nherbaut/pico-power-sensor/config/README.md

# Configuration

Store shared, non-secret schemas and examples here. Put credentials and local deployment values in ignored `config/local/` or `.env` files.

Per-run configuration must include the Pi model/RAM, HAT model, cooling policy, peripherals and external power boundaries, OS/kernel, software versions, UART/marker mapping, acquisition settings and calibration revision.
