nherbaut/pico-power-sensor/nodes/README.md

# Instruments

Use `PP-xxx` for instruments and separate identifiers for DUTs. A single instrument can measure several Pi/HAT configurations.

Copy the [instrument template](_template/README.md) only after creating a real instrument. No assembled instrument exists yet.
