nherbaut/pico-power-sensor/hardware/pcb/carrier/pinout.csv

reference | pin | net
J_PICO | 1 | PICO_TX
J_PICO | 2 | PICO_RX
J_PICO | 3 | GND
J_PICO | 4 | PICO_MARK
J_PICO | 5 | ALERT
J_PICO | 6 | LED1_GPIO
J_PICO | 7 | LED2_GPIO
J_PICO | 8 | GND
J_PICO | 9 | LED3_GPIO
J_PICO | 10 | LED4_GPIO
J_PICO | 11 | LED5_GPIO
J_PICO | 12 | NC
J_PICO | 13 | GND
J_PICO | 14 | NC
J_PICO | 15 | NC
J_PICO | 16 | SD_MISO
J_PICO | 17 | SD_CS
J_PICO | 18 | GND
J_PICO | 19 | SD_SCLK
J_PICO | 20 | SD_MOSI
J_PICO | 21 | MISO
J_PICO | 22 | CS
J_PICO | 23 | GND
J_PICO | 24 | SCLK
J_PICO | 25 | MOSI
J_PICO | 26 | NC
J_PICO | 27 | NC
J_PICO | 28 | GND
J_PICO | 29 | NC
J_PICO | 30 | NC
J_PICO | 31 | NC
J_PICO | 32 | NC
J_PICO | 33 | GND
J_PICO | 34 | NC
J_PICO | 35 | NC
J_PICO | 36 | PICO_3V3
J_PICO | 37 | NC
J_PICO | 38 | GND
J_PICO | 39 | NC
J_PICO | 40 | USB_5V
J_UART | 1 | GND
J_UART | 2 | PICO_RX
J_UART | 3 | PICO_TX
J_UART | 4 | PICO_MARK
J_UART | 5 | PICO_3V3
J_EVM | 1 | CS
J_EVM | 2 | NC
J_EVM | 3 | SCLK
J_EVM | 4 | GND
J_EVM | 5 | MOSI
J_EVM | 6 | PICO_3V3
J_EVM | 7 | MISO
J_EVM | 8 | ALERT
J_EVM | 9 | NC
J_EVM | 10 | NC
J_EVM | 11 | NC
J_EVM | 12 | NC
D1 | 1 | GND
D1 | 2 | LED1_A
R_LED1 | 1 | LED1_GPIO
R_LED1 | 2 | LED1_A
R_PD1 | 1 | LED1_GPIO
R_PD1 | 2 | GND
D2 | 1 | GND
D2 | 2 | LED2_A
R_LED2 | 1 | LED2_GPIO
R_LED2 | 2 | LED2_A
R_PD2 | 1 | LED2_GPIO
R_PD2 | 2 | GND
D3 | 1 | GND
D3 | 2 | LED3_A
R_LED3 | 1 | LED3_GPIO
R_LED3 | 2 | LED3_A
R_PD3 | 1 | LED3_GPIO
R_PD3 | 2 | GND
D4 | 1 | GND
D4 | 2 | LED4_A
R_LED4 | 1 | LED4_GPIO
R_LED4 | 2 | LED4_A
R_PD4 | 1 | LED4_GPIO
R_PD4 | 2 | GND
D5 | 1 | GND
D5 | 2 | LED5_A
R_LED5 | 1 | LED5_GPIO
R_LED5 | 2 | LED5_A
R_PD5 | 1 | LED5_GPIO
R_PD5 | 2 | GND
R_CS | 1 | PICO_3V3
R_CS | 2 | CS
C1 | 1 | PICO_3V3
C1 | 2 | GND
C2 | 1 | PICO_3V3
C2 | 2 | GND
TP1 | 1 | PICO_3V3
TP2 | 1 | GND
J_SD | 1 | SD_DAT2
J_SD | 2 | SD_CS
J_SD | 3 | SD_MOSI
J_SD | 4 | SD_3V3
J_SD | 5 | SD_SCLK
J_SD | 6 | GND
J_SD | 7 | SD_MISO
J_SD | 8 | SD_DAT1
J_SD | 9 | GND
U_SD | 1 | USB_5V
U_SD | 2 | GND
U_SD | 3 | PICO_3V3
U_SD | 4 | NC
U_SD | 5 | SD_3V3
R_SDP1 | 1 | SD_3V3
R_SDP1 | 2 | SD_DAT2
R_SDP2 | 1 | SD_3V3
R_SDP2 | 2 | SD_CS
R_SDP3 | 1 | SD_3V3
R_SDP3 | 2 | SD_MOSI
R_SDP4 | 1 | SD_3V3
R_SDP4 | 2 | SD_MISO
R_SDP5 | 1 | SD_3V3
R_SDP5 | 2 | SD_DAT1
C_SDIN | 1 | USB_5V
C_SDIN | 2 | GND
C_SDOUT | 1 | SD_3V3
C_SDOUT | 2 | GND
C_SDBULK | 1 | SD_3V3
C_SDBULK | 2 | GND
C_SDSOCKET | 1 | SD_3V3
C_SDSOCKET | 2 | GND
