nherbaut/pico-power-sensor/hardware/pcb/carrier/schematic.png

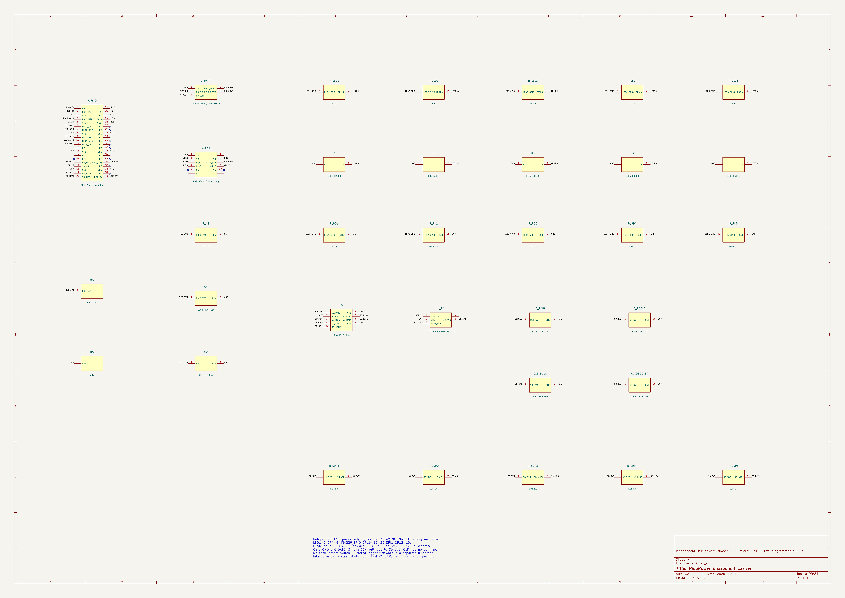
hardware/pcb/carrier/schematic.png
