nherbaut/pico-power-sensor/hardware/pcb/interposer/schematic.png

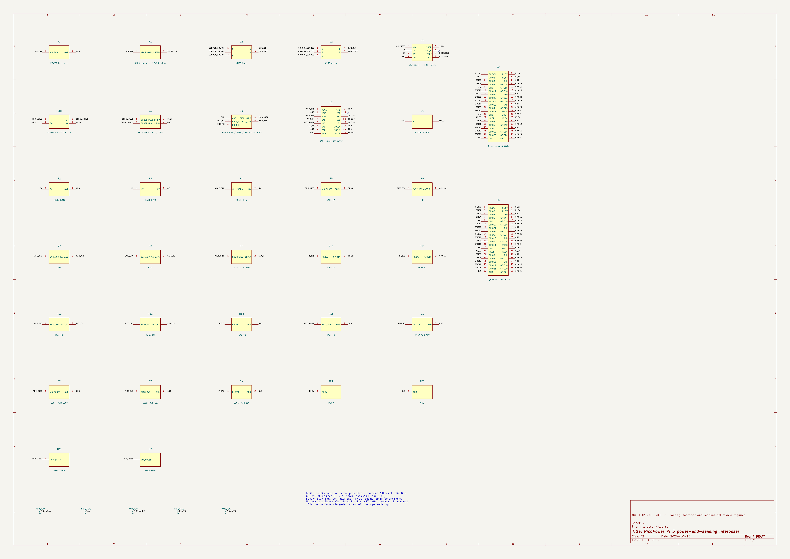
hardware/pcb/interposer/schematic.png
