nherbaut/pico-power-sensor/img/picoinamount.png

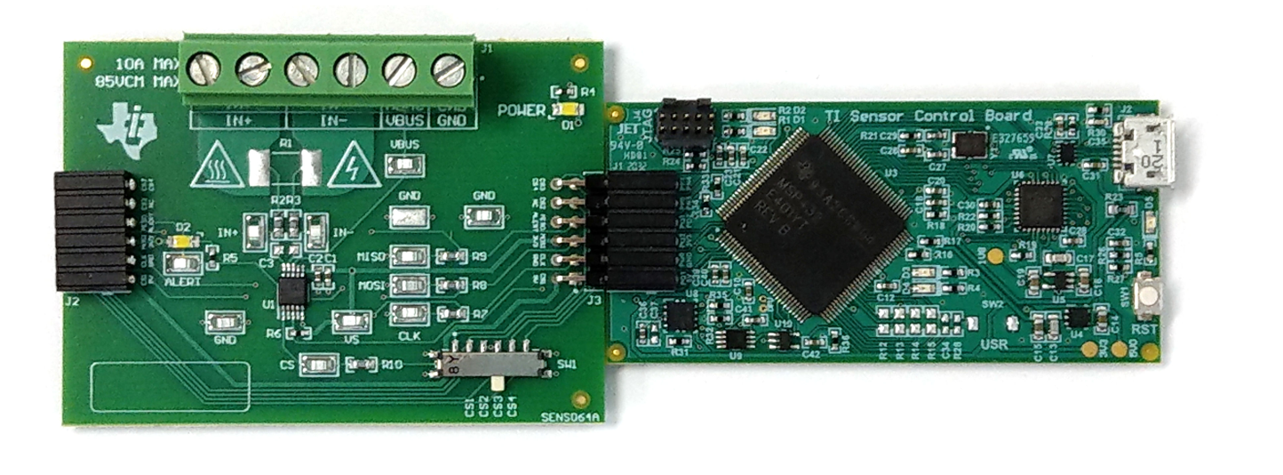
img/picoinamount.png
