nherbaut/pico-power-sensor/hardware/bom.csv

component_id | function | manufacturer | model | manufacturer_reference | supplier | supplier_reference | quantity_per_instrument | quantity_total | quantity_unit | hardware_revision | validation_status | documentation_url | product_url | notes
HW-001 | Acquisition controller | Raspberry Pi | Pico 2 W with headers | Pico 2 W |  |  | 1 | 1 | piece | A-draft | proposed; review required | https://datasheets.raspberrypi.com/picow/pico-2-w-datasheet.pdf |  | Separate USB supply; headered variant or headers fitted before assembly
HW-002 | Power monitor | Texas Instruments | INA229EVM | INA229EVM | DigiKey | 296-INA229EVM-ND | 1 | 1 | piece | A-draft | proposed; review required | https://www.ti.com/tool/INA229_239EVM | https://www.digikey.fr/fr/products/detail/texas-instruments/INA229EVM/13636647 | No TI-SCB; use direct SPI; onboard shunt left empty
HW-003 | DUT supply | Korad | U202 | U202 |  |  | 1 | 1 | piece | A-draft | user-reported owned; not inspected | https://priniotakiselectronics.gr/image/KORAD/U202Englishusermanual.pdf |  | User reports owning this supply; 5.10 V and maximum 5.00 A for bench tests; not a new purchase
HW-004 | Device under test | Raspberry Pi | Raspberry Pi 5 | Raspberry Pi 5 |  |  | 1 | 1 | piece | A-draft | proposed; review required | https://www.raspberrypi.com/products/raspberry-pi-5/ |  | First selected DUT; ownership and RAM capacity not recorded; outside instrument purchase total
HW-005 | Interposer PCB | Custom | Power-and-sensing interposer | PP-INTERPOSER-A |  |  | 1 | 1 | piece | A-draft | proposed; review required |  |  | Routed KiCad review draft; 67.13x46 mm provisional envelope; no fabrication release
HW-006 | J1 | Phoenix Contact | POWER IN + / - | 1776508 |  |  | 1 | 1 | piece | A-draft | proposed; review required | https://www.phoenixcontact.com/en-us/products/pcb-header-mstb-25-2-gf-508-1776508 |  | Board component; Power_GF_2; manufacturer footprint review required
HW-007 | F1 | Schurter | 6.3 A candidate / 5x20 holder | 0031.8201 |  |  | 1 | 1 | piece | A-draft | proposed; review required | https://at.schurter.com/en/datasheet/typ_OGN.pdf |  | Board component; Fuse_OGN_P22.5; manufacturer footprint review required
HW-008 | Q1 | Infineon | NMOS input | BSC010N04LS6ATMA1 |  |  | 1 | 1 | piece | A-draft | proposed; review required | https://www.infineon.com/part/BSC010N04LS6 |  | Board component; SuperSO8_Draft; manufacturer footprint review required
HW-009 | Q2 | Infineon | NMOS output | BSC010N04LS6ATMA1 |  |  | 1 | 1 | piece | A-draft | proposed; review required | https://www.infineon.com/part/BSC010N04LS6 |  | Board component; SuperSO8_Draft; manufacturer footprint review required
HW-010 | U1 | Analog Devices | LTC4367 protection switch | LTC4367IMS8#PBF |  |  | 1 | 1 | piece | A-draft | proposed; review required | https://www.analog.com/media/en/technical-documentation/data-sheets/ltc4367.pdf |  | Board component; MSOP8_P0.65; manufacturer footprint review required
HW-011 | RSH1 | Vishay | 5 mOhm / 0.5% / 1 W | WSK25125L000DEA |  |  | 1 | 1 | piece | A-draft | proposed; review required | https://www.vishay.com/docs/30108/wsk2512.pdf |  | Board component; WSK2512_5m_Kelvin; manufacturer footprint review required
HW-012 | J2 | Samtec | 40-pin stacking socket | SSQ-120-03-G-D |  |  | 1 | 1 | piece | A-draft | proposed; review required | https://www.samtec.com/products/ssq-120-03-g-d |  | Board component; Stack_2x20_P2.54; manufacturer footprint review required
HW-013 | J3 | JST | S+ / S- / VBUS / GND | B4B-XH-A(LF)(SN) |  |  | 1 | 1 | piece | A-draft | proposed; review required | https://www.jst-mfg.com/product/pdf/eng/eXH.pdf |  | Board component; XH4_P2.5; manufacturer footprint review required
HW-014 | J4 | JST | GND / PiTX / PiRX / MARK / Pico3V3 | B5B-XH-A(LF)(SN) |  |  | 1 | 1 | piece | A-draft | proposed; review required | https://www.jst-mfg.com/product/pdf/eng/eXH.pdf |  | Five-pin UART; buffered signals; pin 5 supplies buffer from Pico 3V3; replaces four-pin harness
HW-015 | R2 | Vishay | 10.0k 0.1% | TNPW080510K0BEEA |  |  | 1 | 1 | piece | A-draft | selected for prototype; release reviews pending | https://www.vishay.com/docs/28758/tnpw_e3.pdf |  | Vishay IPC copper lands applied; tolerance/temperature calculations updated; protection transient and final assembly review pending; see docs/design-review.md
HW-016 | R3 | Vishay | 1.50k 0.1% | TNPW08051K50BEEA |  |  | 1 | 1 | piece | A-draft | selected for prototype; release reviews pending | https://www.vishay.com/docs/28758/tnpw_e3.pdf |  | Vishay IPC copper lands applied; tolerance/temperature calculations updated; protection transient and final assembly review pending; see docs/design-review.md
HW-017 | R4 | Vishay | 95.3k 0.1% | TNPW080595K3BEEA |  |  | 1 | 1 | piece | A-draft | selected for prototype; release reviews pending | https://www.vishay.com/docs/28758/tnpw_e3.pdf |  | Vishay IPC copper lands applied; tolerance/temperature calculations updated; protection transient and final assembly review pending; see docs/design-review.md
HW-018 | R5 | Vishay | 510k 1% | CRCW0805510KFKEA |  |  | 1 | 1 | piece | A-draft | selected for prototype; release reviews pending | https://www.vishay.com/docs/20035/dcrcwe3.pdf |  | Selected in CAD/BOM; assembly sourcing and final footprint/process review pending; see docs/design-review.md
HW-019 | R6, R7 | Vishay | 10R | CRCW080510R0FKEA |  |  | 2 | 2 | piece | A-draft | selected for prototype; release reviews pending | https://www.vishay.com/docs/20035/dcrcwe3.pdf |  | Selected in CAD/BOM; assembly sourcing and final footprint/process review pending; see docs/design-review.md
HW-020 | R8 | Vishay | 5.1k | CRCW08055K10FKEA |  |  | 1 | 1 | piece | A-draft | selected for prototype; release reviews pending | https://www.vishay.com/docs/20035/dcrcwe3.pdf |  | Selected in CAD/BOM; assembly sourcing and final footprint/process review pending; see docs/design-review.md
HW-021 | C1 | KEMET | 12nF C0G 50V | C0805C123J5GACTU |  |  | 1 | 1 | piece | A-draft | selected for prototype; release reviews pending | https://content.kemet.com/datasheets/KEM_C1003_C0G_SMD.pdf |  | Selected in CAD/BOM; assembly sourcing and final footprint/process review pending; see docs/design-review.md
HW-022 | C2 | Murata | 100nF X7R 100V | GRM21BR72A104JAC4L |  |  | 1 | 1 | piece | A-draft | selected for prototype; release reviews pending | https://www.murata.com/en-us/products/productdetail?partno=GRM21BR72A104JAC4%23 |  | GRM21 recommended reflow lands applied; effective capacitance, lifecycle and assembly sourcing pending; see docs/design-review.md
HW-023 | Replaceable cartridge fuse | Littelfuse | 6.3 A fast candidate | 021706.3MXP |  |  | 1 | 1 | piece | A-draft | proposed; review required | https://www.littelfuse.com/assetdocs/littelfuse-fuse-217-datasheet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 | https://www.tme.eu/en/details/021706.3mxp/fuses-5x20mm-fast/littelfuse/ | Manufacturer lists 70A interrupting rating at 60VDC for 6.3A variant; nominal cold resistance 9.5mOhm; max 130mV drop at rated 6.3A, not a 5A guarantee; will not reliably clear with Korad limited to 5A
HW-024 | Mating input plug | Phoenix Contact | MSTB 2,5/2-STF-5,08 | 1777989 |  |  | 1 | 1 | piece | A-draft | proposed; review required | https://www.phoenixcontact.com/en-us/products/pcb-plug-mstb-25-2-stf-508-1777989 |  | Screw-flanged polarized mating plug for J1; verify flange fasteners
HW-025 | Sense cable housing | JST | XH four-way housing | XHP-4 |  |  | 1 | 1 | piece | A-draft | proposed; review required | https://www.jst-mfg.com/product/pdf/eng/eXH.pdf |  | Four-way XHP-4 for J3 only; 4 matching crimp contacts; separate five-way UART harness
HW-026 | Power harness | To select | 4 mm banana plugs and short 18 AWG leads |  |  |  | 1 | 1 | piece | A-draft | proposed; review required |  |  | Verify Korad socket type; keyed board input; adequate strain relief; no crocodile clips on Pi
HW-027 | Instrument supply | To select | Regulated USB 5 V supply and Pico cable |  |  |  | 1 | 1 | piece | A-draft | proposed; review required |  |  | Independent of measured DUT rail; verify grounding with reference equipment
HW-028 | Mechanical support | To select | M2.5 mounting hardware and side-wing support |  |  |  | 1 | 1 | piece | A-draft | proposed; review required |  |  | Finalize after Pi/Active Cooler/AI HAT mock-up; header is not a strain-relief support
HW-029 | D1 power indicator | Kingbright | Low-current green 0805 LED | APT2012LZGCK |  |  | 1 | 1 | piece | A-draft | proposed; review required | https://www.kingbrightusa.com/images/catalog/spec/apt2012lzgck.pdf |  | Protected supply before shunt; cathode pad 1; about 1 mA with R9; footprint/polarity and brightness review required
HW-030 | R9 LED current limiting | Vishay | 2.7k 1% 0.125W | CRCW08052K70FKEA |  |  | 1 | 1 | piece | A-draft | selected for prototype; release reviews pending | https://www.vishay.com/docs/20035/dcrcwe3.pdf |  | Selected in CAD/BOM; assembly sourcing and final footprint/process review pending; see docs/design-review.md
HW-031 | U2 UART power-off buffer | Texas Instruments | SN74AXC4T245 TSSOP-16 | SN74AXC4T245PWR |  |  | 1 | 1 | piece | A-draft | proposed; review required | https://www.ti.com/lit/ds/symlink/sn74axc4t245.pdf |  | Dual separate 3V3 domains; Pi-side current included in DUT measurements; physical power-off tests pending
HW-032 | C3/C4 buffer decoupling | Murata | 100nF X7R 16V | GRM21BR71C104KA01L |  |  | 2 | 2 | piece | A-draft | selected for prototype; release reviews pending | https://search.murata.co.jp/Ceramy/image/img/A01X/G101/ENG/GRM21BR71C104KA01-01.pdf |  | GRM21 recommended reflow lands applied; effective capacitance, lifecycle and assembly sourcing pending; see docs/design-review.md
HW-033 | R10-R15 local signal bias | Vishay | 100k 1% | CRCW0805100KFKEA |  |  | 6 | 6 | piece | A-draft | selected for prototype; release reviews pending | https://www.vishay.com/docs/20035/dcrcwe3.pdf |  | Selected in CAD/BOM; assembly sourcing and final footprint/process review pending; see docs/design-review.md
HW-034 | UART cable housing | JST | XH five-way housing | XHP-5 |  |  | 2 | 2 | piece | A-draft | proposed; review required | https://www.jst-mfg.com/product/pdf/eng/eXH.pdf |  | Two XHP-5 housings for straight-through carrier-to-interposer cable; five contacts per end
HW-035 | Carrier J_UART | JST | XH five-pin vertical header | B5B-XH-A(LF)(SN) |  |  | 1 | 1 | piece | A-draft | CAD draft; footprint and bench validation pending | https://www.jst-mfg.com/product/pdf/eng/eXH.pdf |  | Carrier CAD draft; pin-for-pin match to interposer J4; physical validation pending
HW-036 | Carrier LED1-LED5 | Kingbright | Low-current green 0805 LED | APT2012LZGCK |  |  | 5 | 5 | piece | A-draft | CAD draft; footprint and bench validation pending | https://www.kingbrightusa.com/images/catalog/spec/apt2012lzgck.pdf |  | GP4-GP8 active-high; independently powered instrument load; physical validation pending
HW-037 | Carrier R_LED1-R_LED5 | Vishay | 1k 1% | CRCW08051K00FKEA |  |  | 5 | 5 | piece | A-draft | selected for prototype; release reviews pending | https://www.vishay.com/docs/20035/dcrcwe3.pdf |  | Selected in CAD/BOM; assembly sourcing and final footprint/process review pending; see docs/design-review.md
HW-038 | Carrier R_PD1-R_PD5 | Vishay | 100k 1% | CRCW0805100KFKEA |  |  | 5 | 5 | piece | A-draft | selected for prototype; release reviews pending | https://www.vishay.com/docs/20035/dcrcwe3.pdf |  | Selected in CAD/BOM; assembly sourcing and final footprint/process review pending; see docs/design-review.md
HW-039 | UART cable contacts | JST | XH crimp contact for 22-28 AWG | SXH-001T-P0.6 |  |  | 10 | 10 | piece | A-draft | specified; CAD and bench validation pending | https://www.jst-mfg.com/product/pdf/eng/eXH.pdf |  | Five contacts per XHP-5 housing; two housings; use suitable crimp tooling
HW-040 | UART five-wire harness | To select | Short five-wire 22 AWG cable |  |  |  | 1 | 1 | piece | A-draft | specified; CAD and bench validation pending |  |  | Straight-through carrier J_UART to interposer J4; verify each numbered pin; no TX/RX crossover
HW-041 | Carrier PCB | Custom | 66x54mm 1.6mm FR4 2x35um copper | PP-CARRIER-A |  |  | 1 | 1 | piece | A-draft | CAD draft; footprint and bench validation pending |  |  | Routed KiCad carrier; no fabrication release
HW-042 | Pico carrier socket strips | Samtec | 1x20 female 2.54mm vertical | SSW-120-01-G-S |  |  | 2 | 2 | piece | A-draft | selected for mechanical review; not released | https://www.samtec.com/products/ssw-120-01-g-s |  | Two manually fitted 1x20 strips; combined J_PICO footprint represents owned module; verify drill, seating and Pico male-header engagement before purchase
HW-043 | Carrier J_EVM | Sullins Connector Solutions | 2x6 female 2mm right-angle socket | NPPN062FJFN-RC |  |  | 1 | 1 | piece | A-draft | CAD draft; footprint and bench validation pending | https://drawings-pdf.s3.amazonaws.com/10461.pdf |  | Direct-plug EVM interface; custom dimensional footprint; mating orientation and height pending
HW-044 | Carrier R_CS | Vishay | 100k 1% | CRCW0805100KFKEA |  |  | 1 | 1 | piece | A-draft | selected for prototype; release reviews pending | https://www.vishay.com/docs/20035/dcrcwe3.pdf |  | Selected in CAD/BOM; assembly sourcing and final footprint/process review pending; see docs/design-review.md
HW-045 | Carrier C1 | Murata | 100nF X7R 16V | GRM21BR71C104KA01L |  |  | 1 | 1 | piece | A-draft | selected for prototype; release reviews pending | https://search.murata.co.jp/Ceramy/image/img/A01X/G101/ENG/GRM21BR71C104KA01-01.pdf |  | GRM21 recommended reflow lands applied; effective capacitance, lifecycle and assembly sourcing pending; see docs/design-review.md
HW-046 | Carrier C2 | Murata | 1uF X7R 16V | GRM21BR71C105KA01L |  |  | 1 | 1 | piece | A-draft | selected for prototype; release reviews pending | https://www.murata.com/en-us/products/productdetail?partno=GRM21BR71C105KA01%23 |  | GRM21 recommended reflow lands applied; effective capacitance, lifecycle and assembly sourcing pending; see docs/design-review.md
HW-047 | Carrier mounting kit | To select | Four M2.5 nylon standoffs and matching screws |  |  |  | 1 | 1 | piece | A-draft | CAD draft; footprint and bench validation pending |  |  | Four 2.7mm holes; 6mm hardware envelope; match EVM height on shared base after physical review
HW-048 | Carrier J_SD | Wurth Elektronik | WR-CRD hinged microSD socket | 693072010801 |  |  | 1 | 1 | piece | A-draft | CAD draft; footprint and bench validation pending | https://www.we-online.com/components/products/datasheet/693072010801.pdf |  | Native microSD_HC_Wuerth footprint; eight card contacts plus grounded shell; no detect switch
HW-049 | Carrier U_SD | Texas Instruments | Dedicated 3.3V SD LDO / SOT-23-5 | TLV75533PDBVR |  |  | 1 | 1 | piece | A-draft | CAD draft; footprint and bench validation pending | https://www.ti.com/lit/gpn/TLV755P |  | USB VBUS input; Pico 3V3 enable; separate SD_3V3 output; 500mA device rating is not a validated continuous board load
HW-050 | Carrier R_SDP1-R_SDP5 | Vishay | 10k 1% | CRCW080510K0FKEA |  |  | 5 | 5 | piece | A-draft | selected for prototype; release reviews pending | https://www.vishay.com/docs/20035/dcrcwe3.pdf |  | Selected in CAD/BOM; assembly sourcing and final footprint/process review pending; see docs/design-review.md
HW-051 | Carrier C_SDIN/C_SDOUT | Murata | 4.7uF X7R 16V | GRM21BR71C475KA73L |  |  | 2 | 2 | piece | A-draft | selected for prototype; release reviews pending | https://search.murata.co.jp/Ceramy/image/img/A01X/G101/ENG/GRM21BR71C475KA73-01.pdf |  | GRM21 recommended reflow lands applied; effective capacitance, lifecycle and assembly sourcing pending; see docs/design-review.md
HW-052 | Carrier C_SDBULK | Samsung Electro-Mechanics | 22uF X5R 16V | CL31A226KOHNNNE |  |  | 1 | 1 | piece | A-draft | selected for prototype; release reviews pending | https://product.samsungsem.com/mlcc/CL31A226KOHNNN.do |  | Explicit X5R change adopted for 10..40 C ambient; component temperature must remain below 85 C; effective capacitance and SD write transients pending; see docs/design-review.md
HW-053 | Carrier C_SDSOCKET | Murata | 100nF X7R 16V | GRM21BR71C104KA01L |  |  | 1 | 1 | piece | A-draft | selected for prototype; release reviews pending | https://search.murata.co.jp/Ceramy/image/img/A01X/G101/ENG/GRM21BR71C104KA01-01.pdf |  | GRM21 recommended reflow lands applied; effective capacitance, lifecycle and assembly sourcing pending; see docs/design-review.md
HW-054 | Measurement storage card | To select | microSDHC 8-32GB / FAT32 default |  |  |  | 1 | 1 | piece | A-draft | CAD draft; footprint and bench validation pending | https://www.sdcard.org/developers/sd-standard-overview/ |  | Validate actual card current and write stalls; no card purchased and no logger firmware implemented
