nherbaut/pico-power-sensor/hardware/pcb/interposer/board-bom.csv

reference | value | manufacturer_reference | footprint | documentation_url | status
J1 | POWER IN + / - | 1776508 | PicoPower:Power_GF_2 | https://www.phoenixcontact.com/en-us/products/pcb-header-mstb-25-2-gf-508-1776508 | prototype selection; release reviews pending
F1 | 6.3 A candidate / 5x20 holder | 0031.8201 | PicoPower:Fuse_OGN_P22.5 | https://at.schurter.com/en/datasheet/typ_OGN.pdf | prototype selection; release reviews pending
Q1 | NMOS input | BSC010N04LS6ATMA1 | PicoPower:SuperSO8_Draft | https://www.infineon.com/part/BSC010N04LS6 | prototype selection; release reviews pending
Q2 | NMOS output | BSC010N04LS6ATMA1 | PicoPower:SuperSO8_Draft | https://www.infineon.com/part/BSC010N04LS6 | prototype selection; release reviews pending
U1 | LTC4367 protection switch | LTC4367IMS8#PBF | PicoPower:MSOP8_P0.65 | https://www.analog.com/media/en/technical-documentation/data-sheets/ltc4367.pdf | prototype selection; release reviews pending
RSH1 | 5 mOhm / 0.5% / 1 W | WSK25125L000DEA | PicoPower:WSK2512_5m_Kelvin | https://www.vishay.com/docs/30108/wsk2512.pdf | prototype selection; release reviews pending
J2 | 40-pin stacking socket | SSQ-120-03-G-D | PicoPower:Stack_2x20_P2.54 | https://www.samtec.com/products/ssq-120-03-g-d | prototype selection; release reviews pending
J3 | S+ / S- / VBUS / GND | B4B-XH-A(LF)(SN) | PicoPower:XH4_P2.5 | https://www.jst-mfg.com/product/pdf/eng/eXH.pdf | prototype selection; release reviews pending
J4 | GND / PiTX / PiRX / MARK / Pico3V3 | B5B-XH-A(LF)(SN) | PicoPower:XH5_P2.5 | https://www.jst-mfg.com/product/pdf/eng/eXH.pdf | prototype selection; release reviews pending
U2 | UART power-off buffer | SN74AXC4T245PWR | PicoPower:TSSOP16_P0.65 | https://www.ti.com/lit/ds/symlink/sn74axc4t245.pdf | prototype selection; release reviews pending
D1 | GREEN POWER | APT2012LZGCK | PicoPower:LED_0805 | https://www.kingbrightusa.com/images/catalog/spec/apt2012lzgck.pdf | prototype selection; release reviews pending
R2 | 10.0k 0.1% | TNPW080510K0BEEA | PicoPower:R_0805_TNPW | https://www.vishay.com/docs/28758/tnpw_e3.pdf | prototype selection; release reviews pending
R3 | 1.50k 0.1% | TNPW08051K50BEEA | PicoPower:R_0805_TNPW | https://www.vishay.com/docs/28758/tnpw_e3.pdf | prototype selection; release reviews pending
R4 | 95.3k 0.1% | TNPW080595K3BEEA | PicoPower:R_0805_TNPW | https://www.vishay.com/docs/28758/tnpw_e3.pdf | prototype selection; release reviews pending
R5 | 510k 1% | CRCW0805510KFKEA | PicoPower:R_0805 | https://www.vishay.com/docs/20035/dcrcwe3.pdf | prototype selection; release reviews pending
R6 | 10R | CRCW080510R0FKEA | PicoPower:R_0805 | https://www.vishay.com/docs/20035/dcrcwe3.pdf | prototype selection; release reviews pending
R7 | 10R | CRCW080510R0FKEA | PicoPower:R_0805 | https://www.vishay.com/docs/20035/dcrcwe3.pdf | prototype selection; release reviews pending
R8 | 5.1k | CRCW08055K10FKEA | PicoPower:R_0805 | https://www.vishay.com/docs/20035/dcrcwe3.pdf | prototype selection; release reviews pending
R9 | 2.7k 1% 0.125W | CRCW08052K70FKEA | PicoPower:R_0805 | https://www.vishay.com/docs/20035/dcrcwe3.pdf | prototype selection; release reviews pending
R10 | 100k 1% | CRCW0805100KFKEA | PicoPower:R_0805 | https://www.vishay.com/docs/20035/dcrcwe3.pdf | prototype selection; release reviews pending
R11 | 100k 1% | CRCW0805100KFKEA | PicoPower:R_0805 | https://www.vishay.com/docs/20035/dcrcwe3.pdf | prototype selection; release reviews pending
R12 | 100k 1% | CRCW0805100KFKEA | PicoPower:R_0805 | https://www.vishay.com/docs/20035/dcrcwe3.pdf | prototype selection; release reviews pending
R13 | 100k 1% | CRCW0805100KFKEA | PicoPower:R_0805 | https://www.vishay.com/docs/20035/dcrcwe3.pdf | prototype selection; release reviews pending
R14 | 100k 1% | CRCW0805100KFKEA | PicoPower:R_0805 | https://www.vishay.com/docs/20035/dcrcwe3.pdf | prototype selection; release reviews pending
R15 | 100k 1% | CRCW0805100KFKEA | PicoPower:R_0805 | https://www.vishay.com/docs/20035/dcrcwe3.pdf | prototype selection; release reviews pending
C1 | 12nF C0G 50V | C0805C123J5GACTU | PicoPower:C_0805_KEMET | https://content.kemet.com/datasheets/KEM_C1003_C0G_SMD.pdf | prototype selection; release reviews pending
C2 | 100nF X7R 100V | GRM21BR72A104JAC4L | PicoPower:C_0805_Murata | https://www.murata.com/en-us/products/productdetail?partno=GRM21BR72A104JAC4%23 | prototype selection; release reviews pending
C3 | 100nF X7R 16V | GRM21BR71C104KA01L | PicoPower:C_0805_Murata | https://search.murata.co.jp/Ceramy/image/img/A01X/G101/ENG/GRM21BR71C104KA01-01.pdf | prototype selection; release reviews pending
C4 | 100nF X7R 16V | GRM21BR71C104KA01L | PicoPower:C_0805_Murata | https://search.murata.co.jp/Ceramy/image/img/A01X/G101/ENG/GRM21BR71C104KA01-01.pdf | prototype selection; release reviews pending
TP1 | PI_5V |  | PicoPower:TestPoint_Pad_2mm |  | prototype selection; release reviews pending
TP2 | GND |  | PicoPower:TestPoint_Pad_2mm |  | prototype selection; release reviews pending
TP3 | PROTECTED |  | PicoPower:TestPoint_Pad_2mm |  | prototype selection; release reviews pending
TP4 | VIN_FUSED |  | PicoPower:TestPoint_Pad_2mm |  | prototype selection; release reviews pending
