nherbaut/pico-power-sensor/hardware/pcb/interposer/pinout.csv

connector | pin | net
J1 | 1 | VIN_RAW
J1 | 2 | GND
J2 | 1 | PI_3V3
J2 | 2 | PI_5V
J2 | 3 | GPIO2
J2 | 4 | PI_5V
J2 | 5 | GPIO3
J2 | 6 | GND
J2 | 7 | GPIO4
J2 | 8 | GPIO14
J2 | 9 | GND
J2 | 10 | GPIO15
J2 | 11 | GPIO17
J2 | 12 | GPIO18
J2 | 13 | GPIO27
J2 | 14 | GND
J2 | 15 | GPIO22
J2 | 16 | GPIO23
J2 | 17 | PI_3V3
J2 | 18 | GPIO24
J2 | 19 | GPIO10
J2 | 20 | GND
J2 | 21 | GPIO9
J2 | 22 | GPIO25
J2 | 23 | GPIO11
J2 | 24 | GPIO8
J2 | 25 | GND
J2 | 26 | GPIO7
J2 | 27 | ID_SD
J2 | 28 | ID_SC
J2 | 29 | GPIO5
J2 | 30 | GND
J2 | 31 | GPIO6
J2 | 32 | GPIO12
J2 | 33 | GPIO13
J2 | 34 | GND
J2 | 35 | GPIO19
J2 | 36 | GPIO16
J2 | 37 | GPIO26
J2 | 38 | GPIO20
J2 | 39 | GND
J2 | 40 | GPIO21
J3 | 1 | SENSE_PLUS
J3 | 2 | SENSE_MINUS
J3 | 3 | PI_5V
J3 | 4 | GND
J4 | 1 | GND
J4 | 2 | PICO_RX
J4 | 3 | PICO_TX
J4 | 4 | PICO_MARK
J4 | 5 | PICO_3V3
J5 | 1 | PI_3V3
J5 | 2 | PI_5V
J5 | 3 | GPIO2
J5 | 4 | PI_5V
J5 | 5 | GPIO3
J5 | 6 | GND
J5 | 7 | GPIO4
J5 | 8 | GPIO14
J5 | 9 | GND
J5 | 10 | GPIO15
J5 | 11 | GPIO17
J5 | 12 | GPIO18
J5 | 13 | GPIO27
J5 | 14 | GND
J5 | 15 | GPIO22
J5 | 16 | GPIO23
J5 | 17 | PI_3V3
J5 | 18 | GPIO24
J5 | 19 | GPIO10
J5 | 20 | GND
J5 | 21 | GPIO9
J5 | 22 | GPIO25
J5 | 23 | GPIO11
J5 | 24 | GPIO8
J5 | 25 | GND
J5 | 26 | GPIO7
J5 | 27 | ID_SD
J5 | 28 | ID_SC
J5 | 29 | GPIO5
J5 | 30 | GND
J5 | 31 | GPIO6
J5 | 32 | GPIO12
J5 | 33 | GPIO13
J5 | 34 | GND
J5 | 35 | GPIO19
J5 | 36 | GPIO16
J5 | 37 | GPIO26
J5 | 38 | GPIO20
J5 | 39 | GND
J5 | 40 | GPIO21
