nherbaut/pico-power-sensor/hardware/review/carrier-mockup.pdf

## PicoPower carrier - unpowered paper mock-up

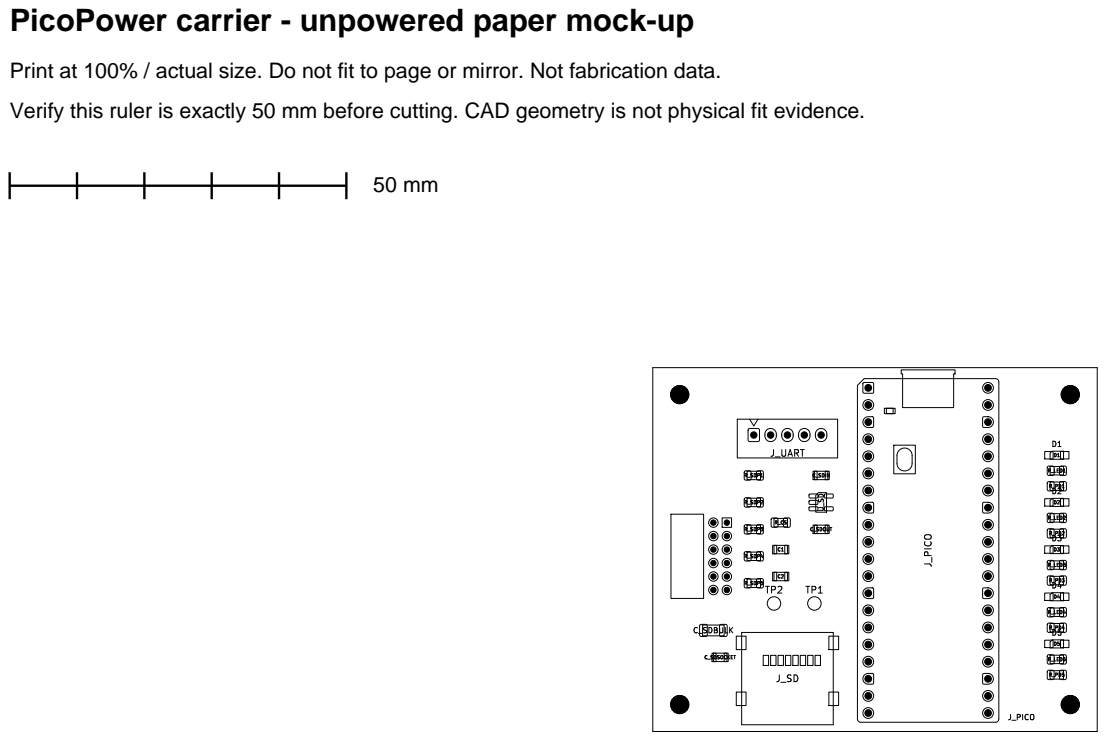
[picture p15: page 1]

Print at 100% / actual size. Do not fit to page or mirror. Not fabrication data.
Verify this ruler is exactly 50 mm before cutting. CAD geometry is not physical fit evidence.
