nherbaut/pico-power-sensor/hardware/pcb/carrier/schematic.pdf

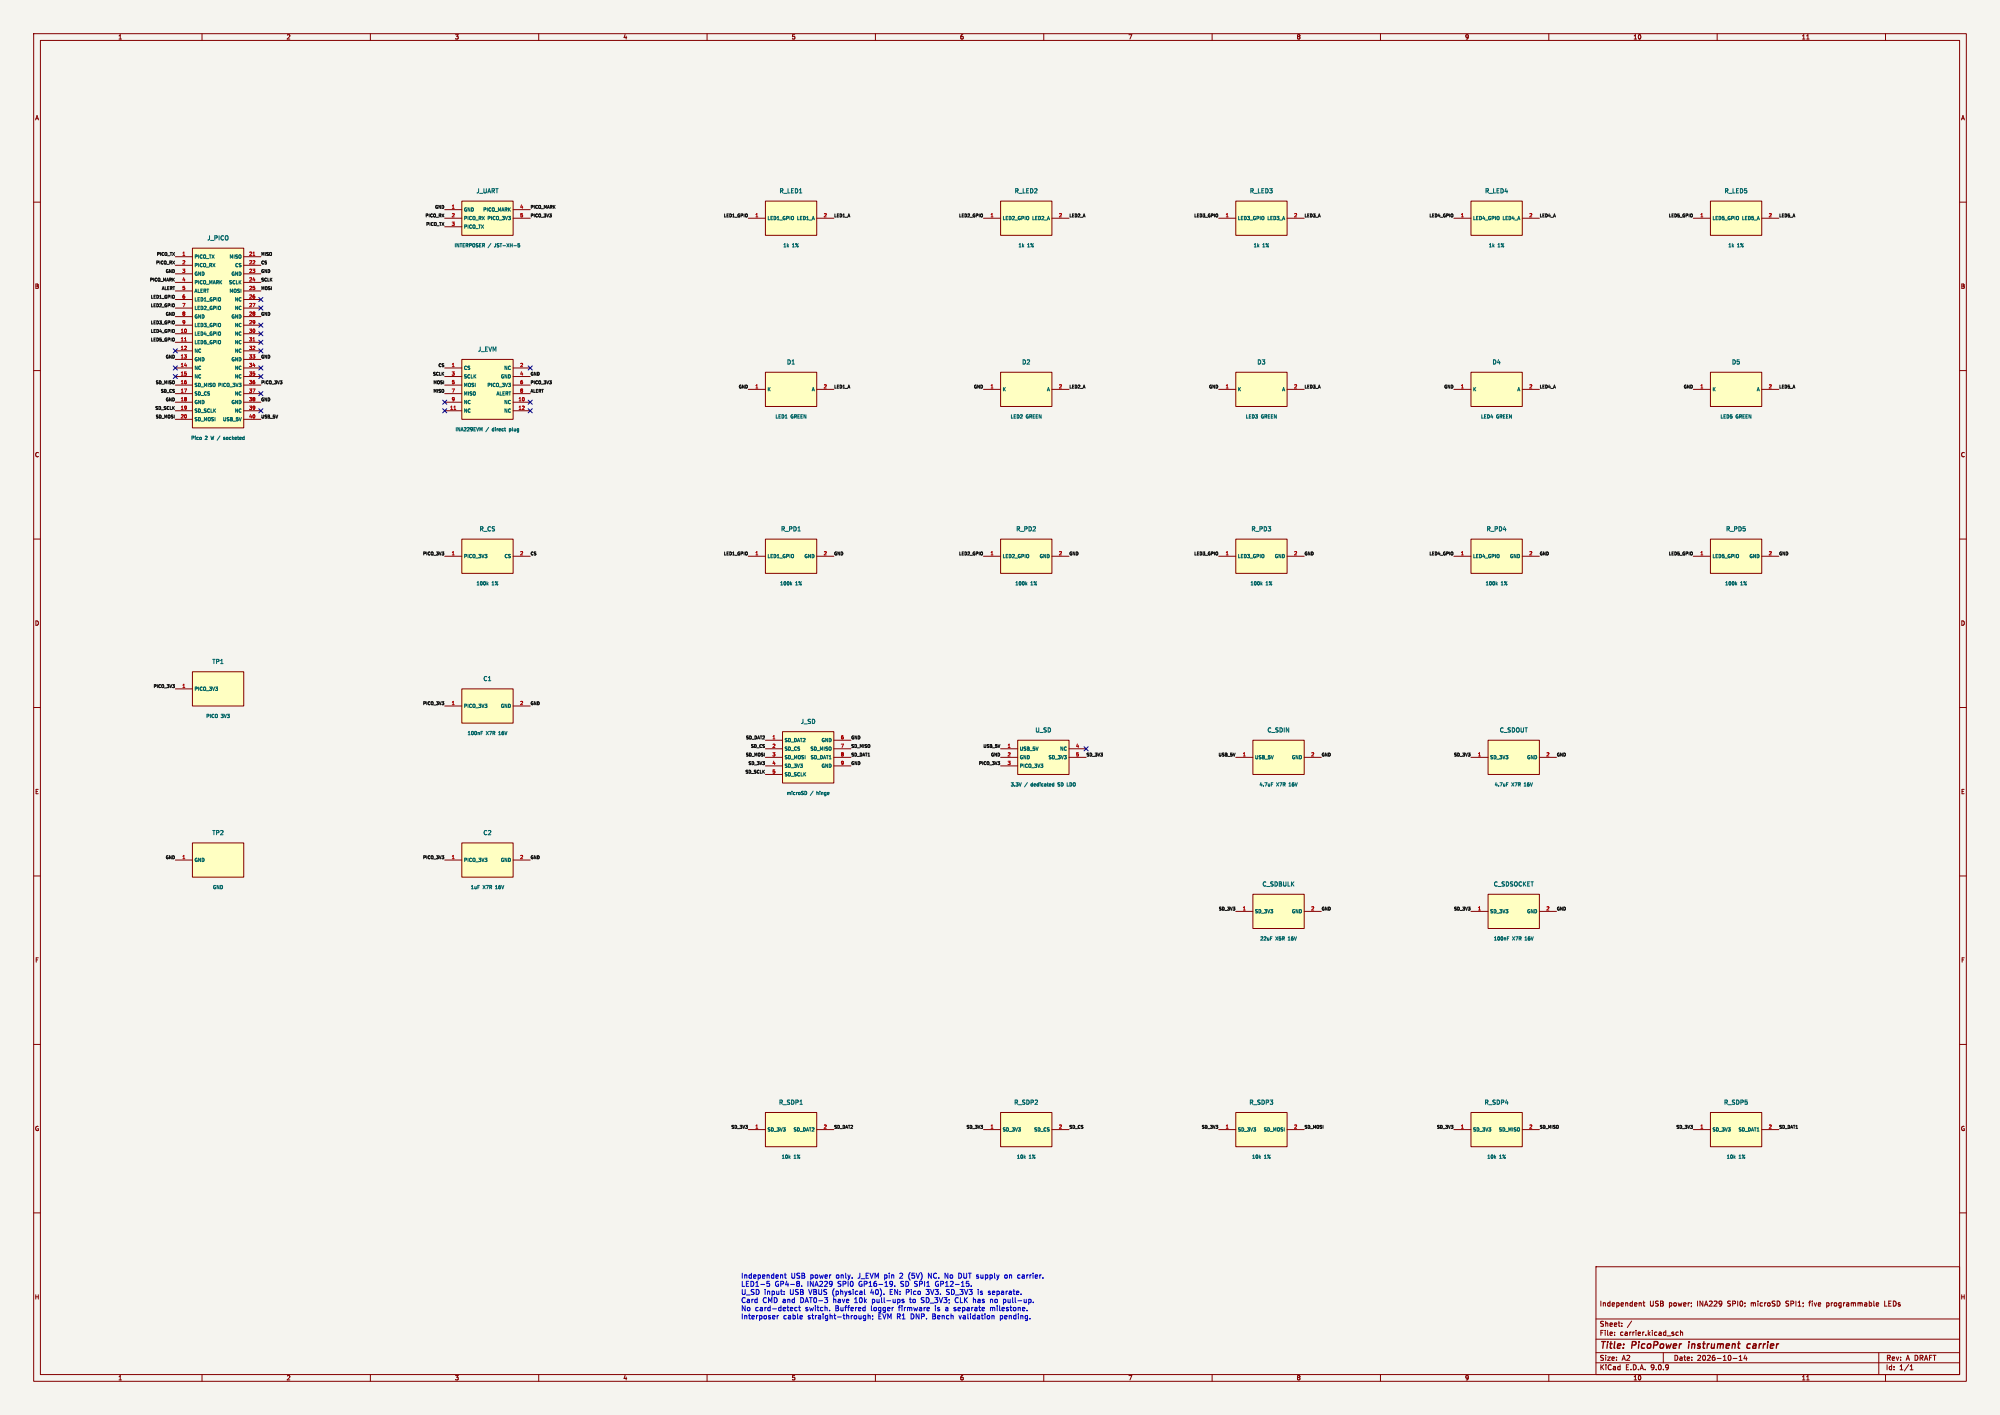
[picture p16: page 1]
