nherbaut/pico-power-sensor/hardware/pcb/interposer/schematic.pdf

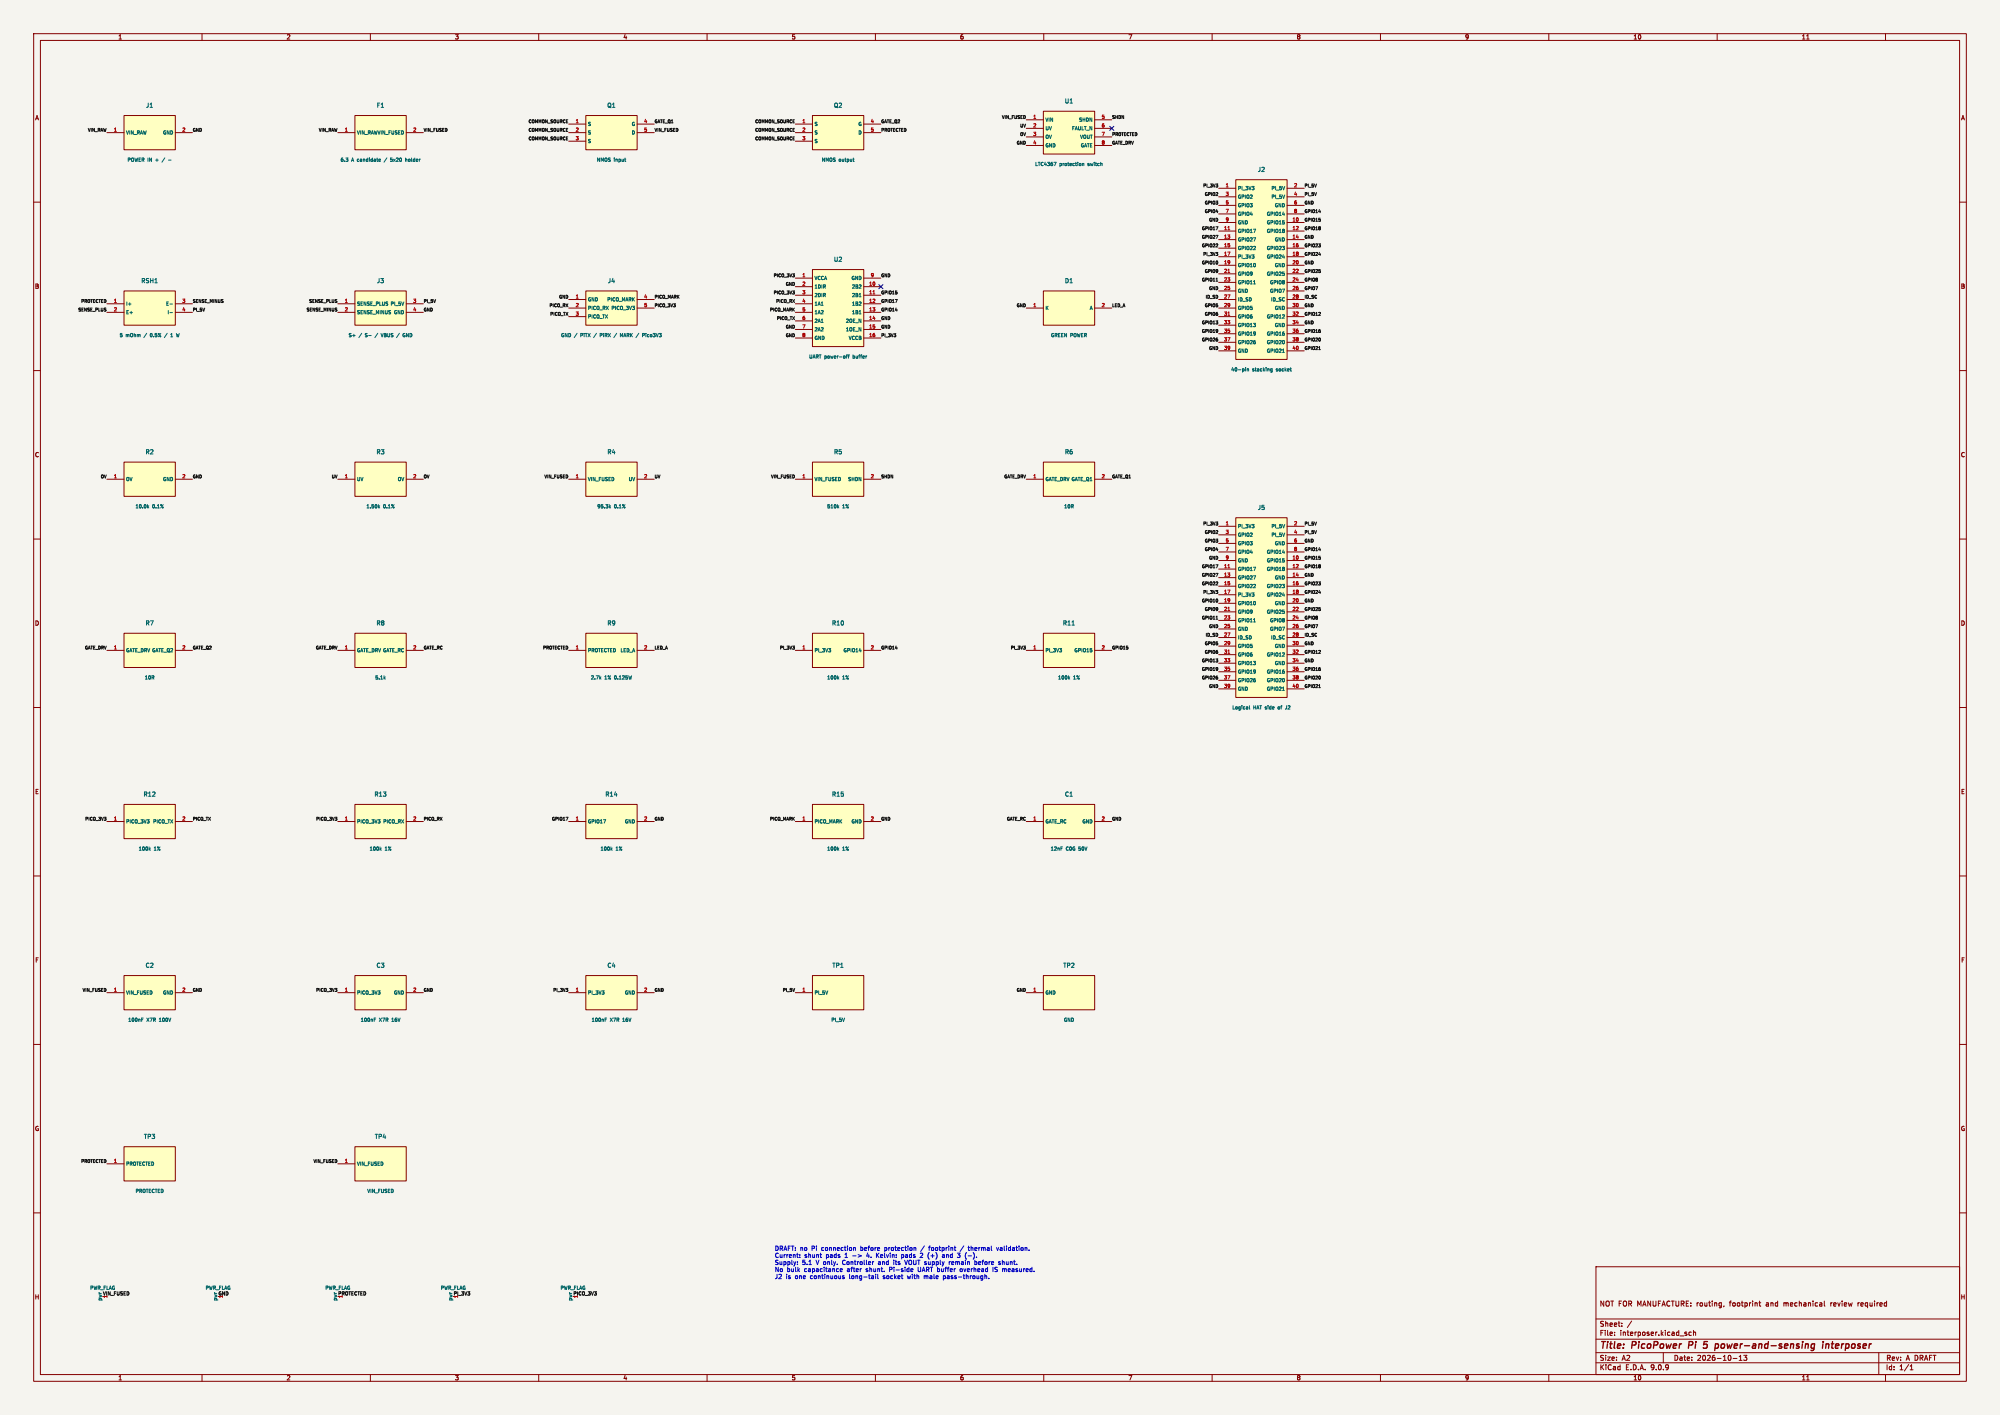
[picture p17: page 1]
