nherbaut/pico-power-sensor/hardware/pcb/interposer/interposer.kicad_pcb

## KiCad design hardware/pcb/interposer/interposer.kicad_pcb (2026-10-14)

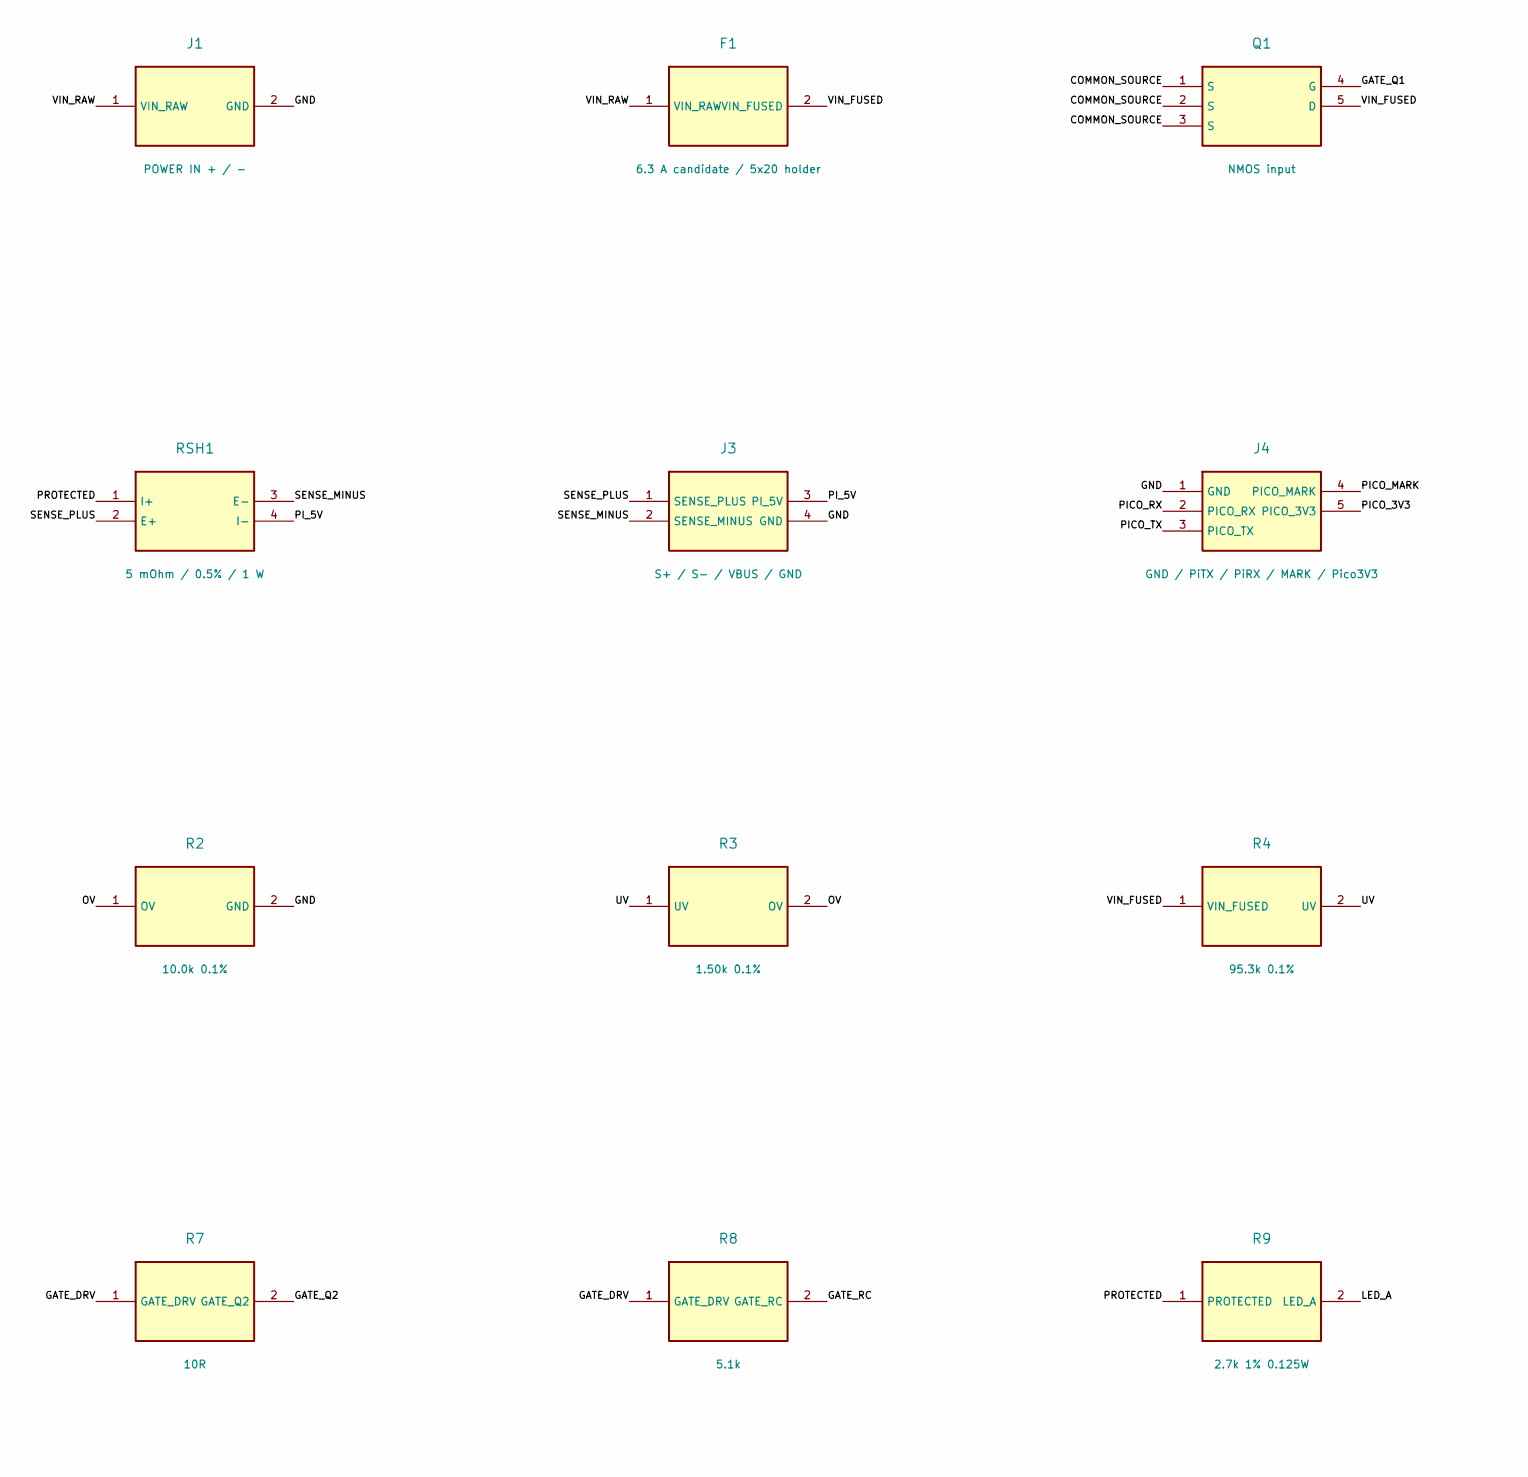
[picture p18: schematic interposer.kicad_sch, PicoPower Pi 5 power-and-sensing interposer, part in row 1, column 1]

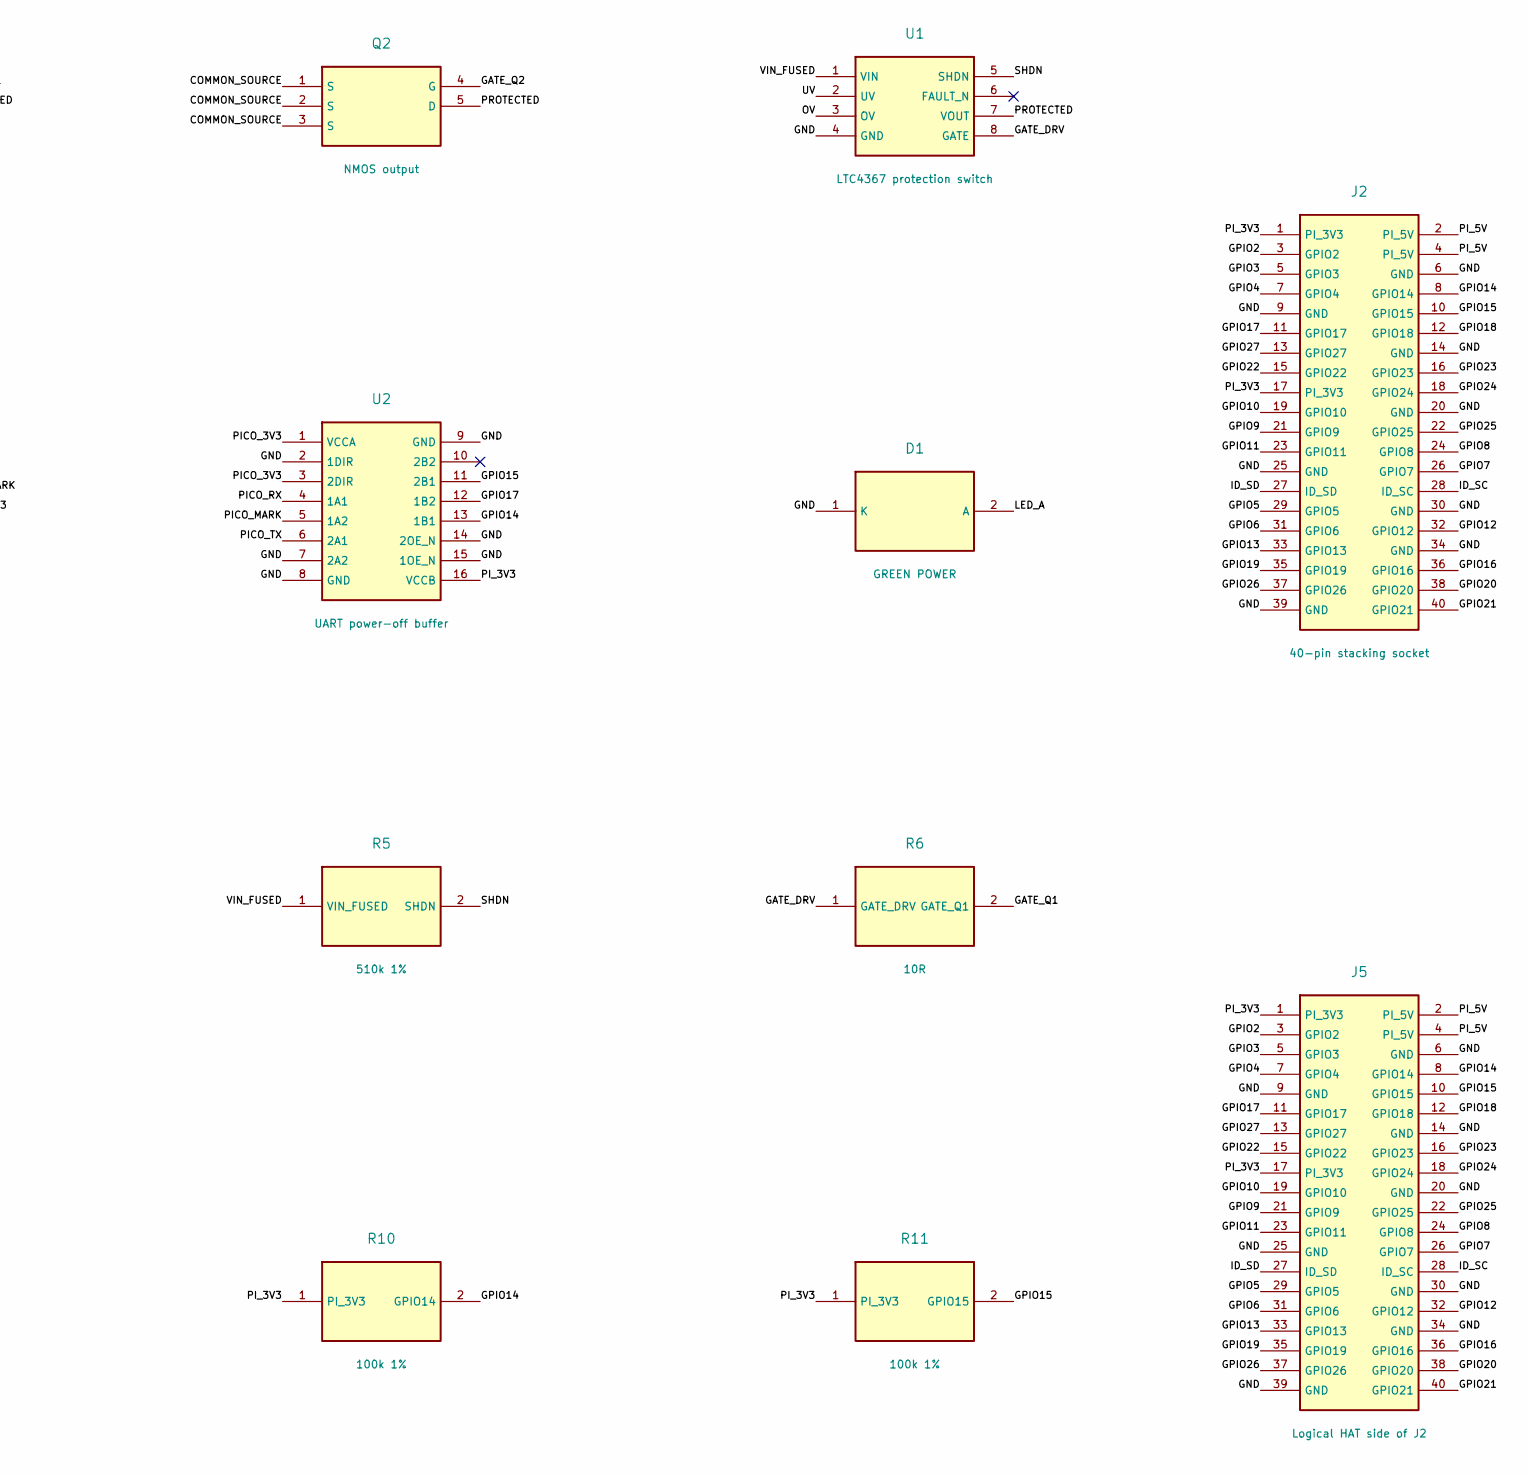
[picture p19: schematic interposer.kicad_sch, PicoPower Pi 5 power-and-sensing interposer, part in row 1, column 2]

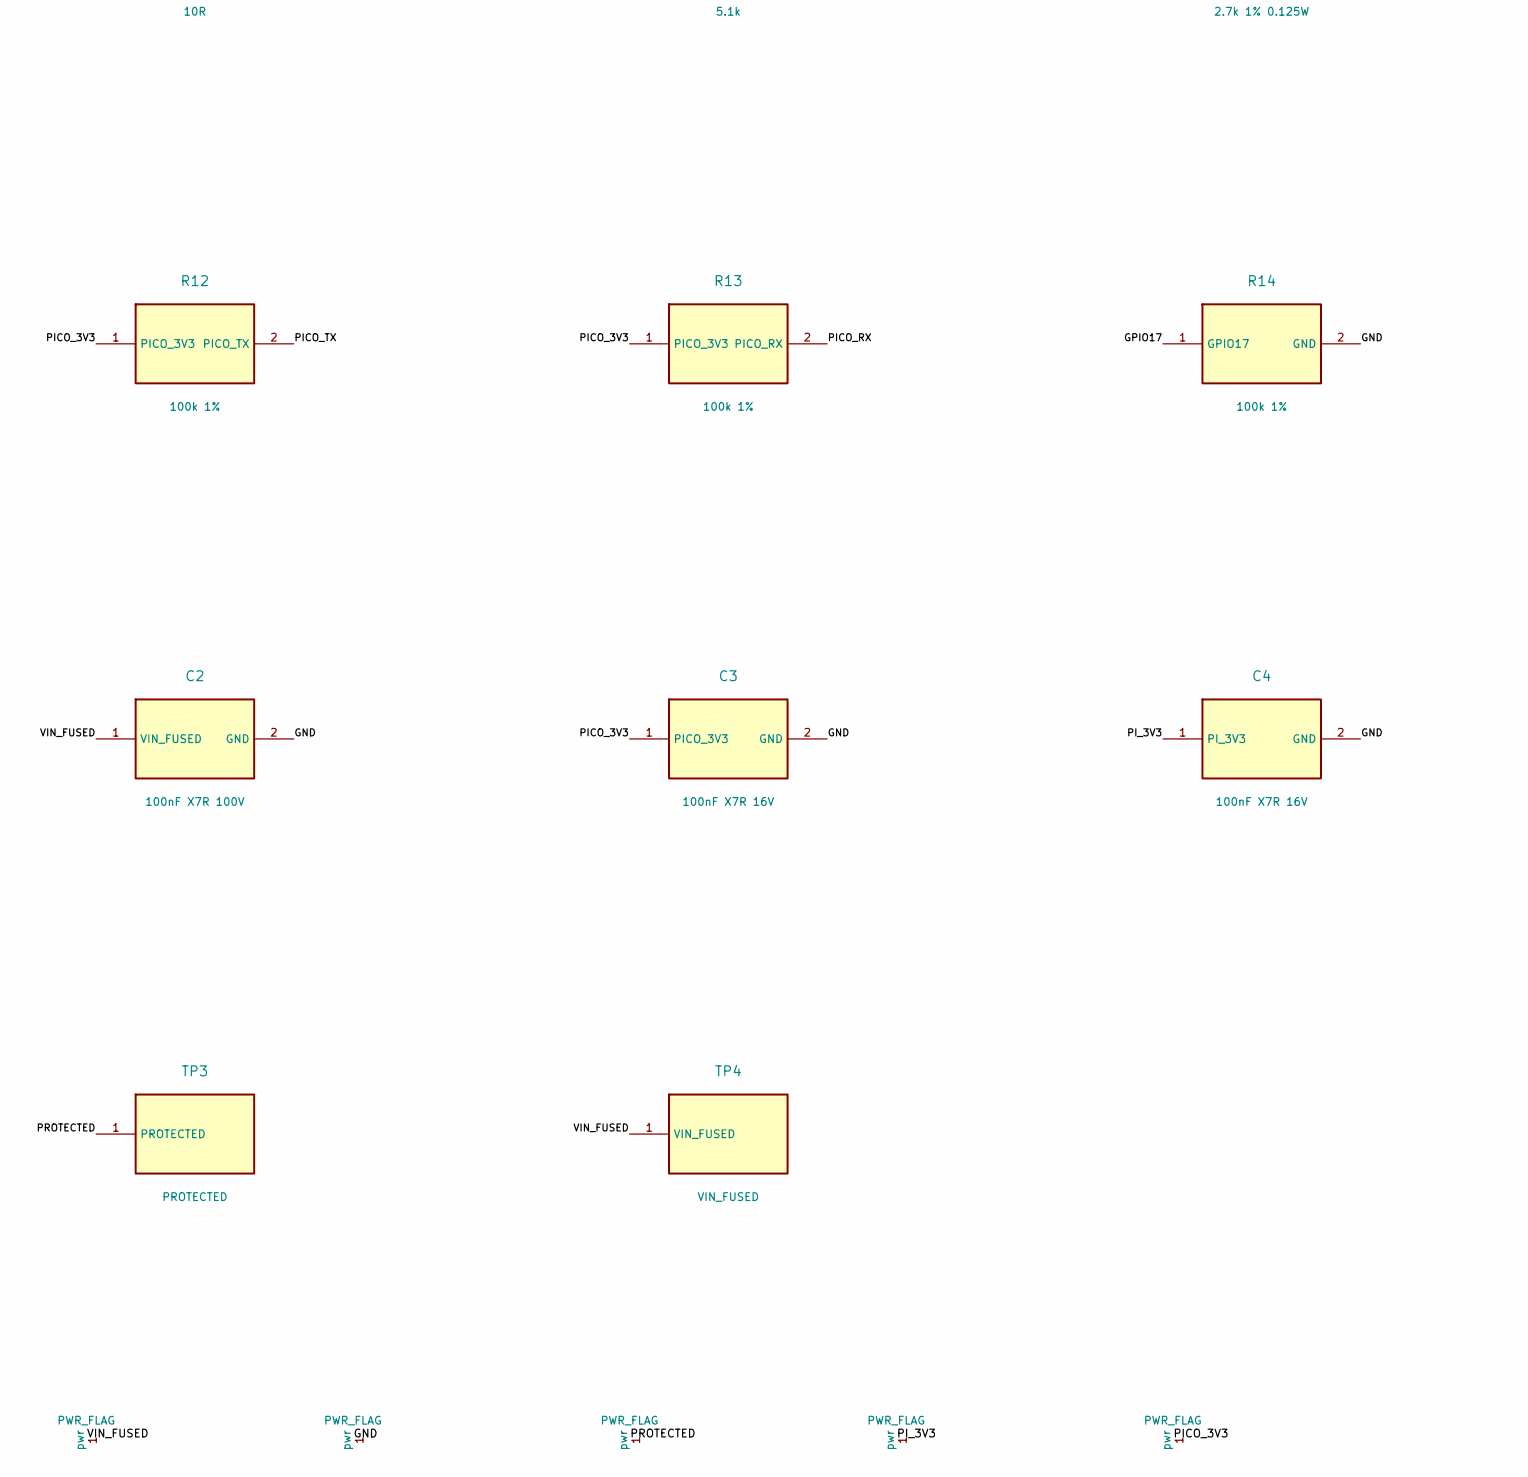
[picture p20: schematic interposer.kicad_sch, PicoPower Pi 5 power-and-sensing interposer, part in row 2, column 1]

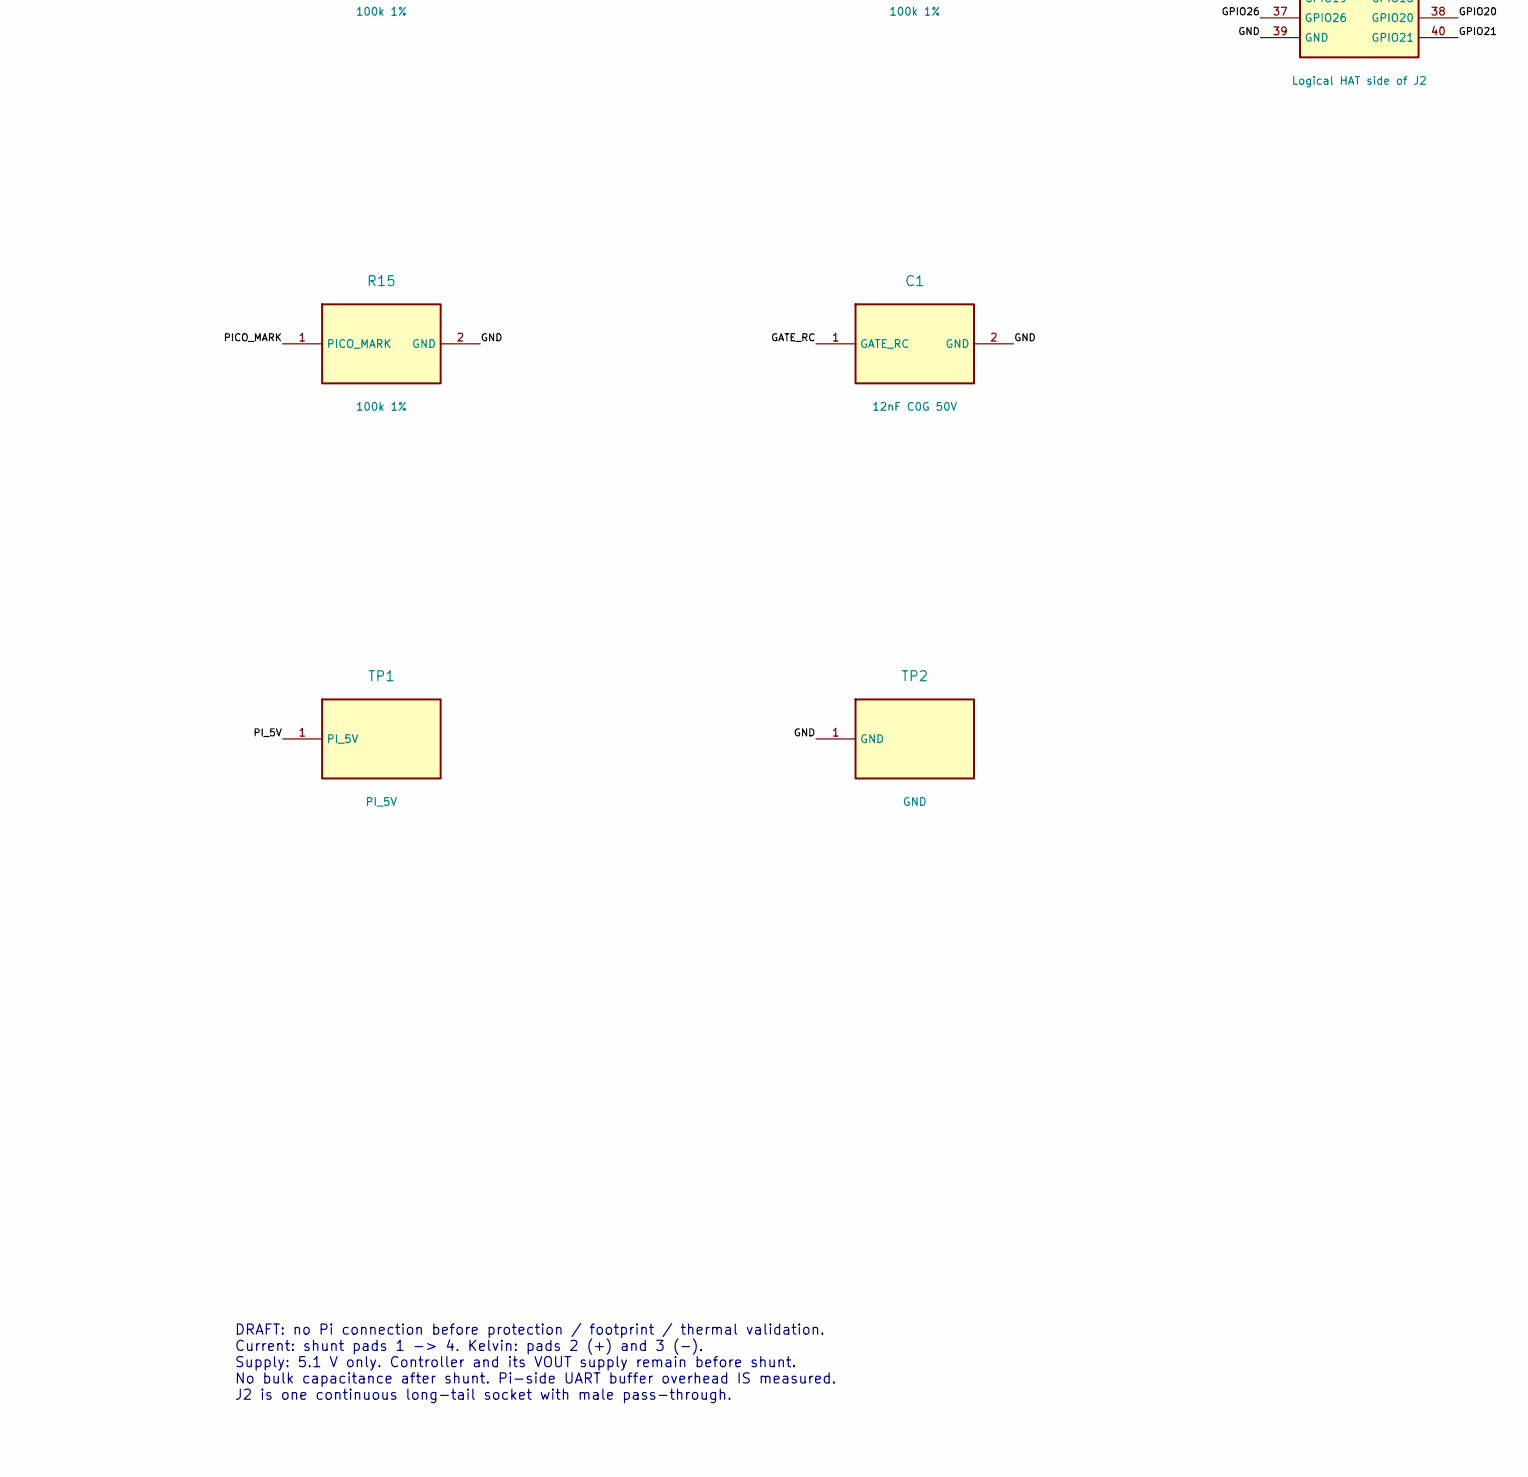
[picture p21: schematic interposer.kicad_sch, PicoPower Pi 5 power-and-sensing interposer, part in row 2, column 2]

Parts:
C1: 12nF C0G 50V; C_0805_KEMET; MPN C0805C123J5GACTU
C2: 100nF X7R 100V; C_0805_Murata; MPN GRM21BR72A104JAC4L
C3, C4: 100nF X7R 16V; C_0805_Murata; MPN GRM21BR71C104KA01L
D1: GREEN POWER; LED_0805; MPN APT2012LZGCK
F1: 6.3 A candidate / 5x20 holder; Fuse_OGN_P22.5; MPN 0031.8201
J1: POWER IN + / -; Power_GF_2; MPN 1776508
J2: 40-pin stacking socket; Stack_2x20_P2.54; MPN SSQ-120-03-G-D
J3: S+ / S- / VBUS / GND; XH4_P2.5; MPN B4B-XH-A(LF)(SN)
J4: GND / PiTX / PiRX / MARK / Pico3V3; XH5_P2.5; MPN B5B-XH-A(LF)(SN)
J5: Logical HAT side of J2; Stack_2x20_P2.54
Q1: NMOS input; SuperSO8_Draft; MPN BSC010N04LS6ATMA1
Q2: NMOS output; SuperSO8_Draft; MPN BSC010N04LS6ATMA1
R2: 10.0k 0.1%; R_0805_TNPW; MPN TNPW080510K0BEEA
R3: 1.50k 0.1%; R_0805_TNPW; MPN TNPW08051K50BEEA
R4: 95.3k 0.1%; R_0805_TNPW; MPN TNPW080595K3BEEA
R5: 510k 1%; R_0805; MPN CRCW0805510KFKEA
R6, R7: 10R; R_0805; MPN CRCW080510R0FKEA
R8: 5.1k; R_0805; MPN CRCW08055K10FKEA
R9: 2.7k 1% 0.125W; R_0805; MPN CRCW08052K70FKEA
R10, R11, R12, R13, R14, R15: 100k 1%; R_0805; MPN CRCW0805100KFKEA
RSH1: 5 mOhm / 0.5% / 1 W; WSK2512_5m_Kelvin; MPN WSK25125L000DEA
TP1: PI_5V; TestPoint_Pad_2mm
TP2: GND; TestPoint_Pad_2mm
TP3: PROTECTED; TestPoint_Pad_2mm
TP4: VIN_FUSED; TestPoint_Pad_2mm
U1: LTC4367 protection switch; MSOP8_P0.65; MPN LTC4367IMS8#PBF
U2: UART power-off buffer; TSSOP16_P0.65; MPN SN74AXC4T245PWR

Connections:
/COMMON_SOURCE: Q1.1 (S), Q1.2 (S), Q1.3 (S), Q2.1 (S), Q2.2 (S), Q2.3 (S)
/GATE_DRV: R6.1 (GATE_DRV), R7.1 (GATE_DRV), R8.1 (GATE_DRV), U1.8 (GATE)
/GATE_Q1: Q1.4 (G), R6.2 (GATE_Q1)
/GATE_Q2: Q2.4 (G), R7.2 (GATE_Q2)
/GATE_RC: C1.1 (GATE_RC), R8.2 (GATE_RC)
/GND: C1.2 (GND), C2.2 (GND), C3.2 (GND), C4.2 (GND), D1.1 (K), J1.2 (GND), J2.6 (GND), J2.9 (GND), J2.14 (GND), J2.20 (GND), J2.25 (GND), J2.30 (GND), J2.34 (GND), J2.39 (GND), J3.4 (GND), J4.1 (GND), J5.6 (GND), J5.9 (GND), J5.14 (GND), J5.20 (GND), J5.25 (GND), J5.30 (GND), J5.34 (GND), J5.39 (GND), R2.2 (GND), R14.2 (GND), R15.2 (GND), TP2.1, U1.4 (GND), U2.2 (1DIR), U2.7 (2A2), U2.8 (GND), U2.9 (GND), U2.14 (2OE_N), U2.15 (1OE_N)
/GPIO2: J2.3 (GPIO2), J5.3 (GPIO2)
/GPIO3: J2.5 (GPIO3), J5.5 (GPIO3)
/GPIO4: J2.7 (GPIO4), J5.7 (GPIO4)
/GPIO5: J2.29 (GPIO5), J5.29 (GPIO5)
/GPIO6: J2.31 (GPIO6), J5.31 (GPIO6)
/GPIO7: J2.26 (GPIO7), J5.26 (GPIO7)
/GPIO8: J2.24 (GPIO8), J5.24 (GPIO8)
/GPIO9: J2.21 (GPIO9), J5.21 (GPIO9)
/GPIO10: J2.19 (GPIO10), J5.19 (GPIO10)
/GPIO11: J2.23 (GPIO11), J5.23 (GPIO11)
/GPIO12: J2.32 (GPIO12), J5.32 (GPIO12)
/GPIO13: J2.33 (GPIO13), J5.33 (GPIO13)
/GPIO14: J2.8 (GPIO14), J5.8 (GPIO14), R10.2 (GPIO14), U2.13 (1B1)
/GPIO15: J2.10 (GPIO15), J5.10 (GPIO15), R11.2 (GPIO15), U2.11 (2B1)
/GPIO16: J2.36 (GPIO16), J5.36 (GPIO16)
/GPIO17: J2.11 (GPIO17), J5.11 (GPIO17), R14.1 (GPIO17), U2.12 (1B2)
/GPIO18: J2.12 (GPIO18), J5.12 (GPIO18)
/GPIO19: J2.35 (GPIO19), J5.35 (GPIO19)
/GPIO20: J2.38 (GPIO20), J5.38 (GPIO20)
/GPIO21: J2.40 (GPIO21), J5.40 (GPIO21)
/GPIO22: J2.15 (GPIO22), J5.15 (GPIO22)
/GPIO23: J2.16 (GPIO23), J5.16 (GPIO23)
/GPIO24: J2.18 (GPIO24), J5.18 (GPIO24)
/GPIO25: J2.22 (GPIO25), J5.22 (GPIO25)
/GPIO26: J2.37 (GPIO26), J5.37 (GPIO26)
/GPIO27: J2.13 (GPIO27), J5.13 (GPIO27)
/ID_SC: J2.28 (ID_SC), J5.28 (ID_SC)
/ID_SD: J2.27 (ID_SD), J5.27 (ID_SD)
/LED_A: D1.2 (A), R9.2 (LED_A)
/OV: R2.1 (OV), R3.2 (OV), U1.3 (OV)
/PICO_3V3: C3.1 (PICO_3V3), J4.5 (PICO_3V3), R12.1 (PICO_3V3), R13.1 (PICO_3V3), U2.1 (VCCA), U2.3 (2DIR)
/PICO_MARK: J4.4 (PICO_MARK), R15.1 (PICO_MARK), U2.5 (1A2)
/PICO_RX: J4.2 (PICO_RX), R13.2 (PICO_RX), U2.4 (1A1)
/PICO_TX: J4.3 (PICO_TX), R12.2 (PICO_TX), U2.6 (2A1)
/PI_3V3: C4.1 (PI_3V3), J2.1 (PI_3V3), J2.17 (PI_3V3), J5.1 (PI_3V3), J5.17 (PI_3V3), R10.1 (PI_3V3), R11.1 (PI_3V3), U2.16 (VCCB)
/PI_5V: J2.2 (PI_5V), J2.4 (PI_5V), J3.3 (PI_5V), J5.2 (PI_5V), J5.4 (PI_5V), RSH1.4 (I-), TP1.1
/PROTECTED: Q2.5 (D), R9.1 (PROTECTED), RSH1.1 (I+), TP3.1, U1.7 (VOUT)
/SENSE_MINUS: J3.2 (SENSE_MINUS), RSH1.3 (E-)
/SENSE_PLUS: J3.1 (SENSE_PLUS), RSH1.2 (E+)
/SHDN: R5.2 (SHDN), U1.5 (SHDN)
/UV: R3.1 (UV), R4.2 (UV), U1.2 (UV)
/VIN_FUSED: C2.1 (VIN_FUSED), F1.2 (VIN_FUSED), Q1.5 (D), R4.1 (VIN_FUSED), R5.1 (VIN_FUSED), TP4.1, U1.1 (VIN)
/VIN_RAW: F1.1 (VIN_RAW), J1.1 (VIN_RAW)

Notes on the sheet:
DRAFT: no Pi connection before protection / footprint / thermal validation. Current: shunt pads 1 -> 4. Kelvin: pads 2 (+) and 3 (-). Supply: 5.1 V only. Controller and its VOUT supply remain before shunt. No bulk capacitance after shunt. Pi-side UART buffer overhead IS measured. J2 is one continuo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

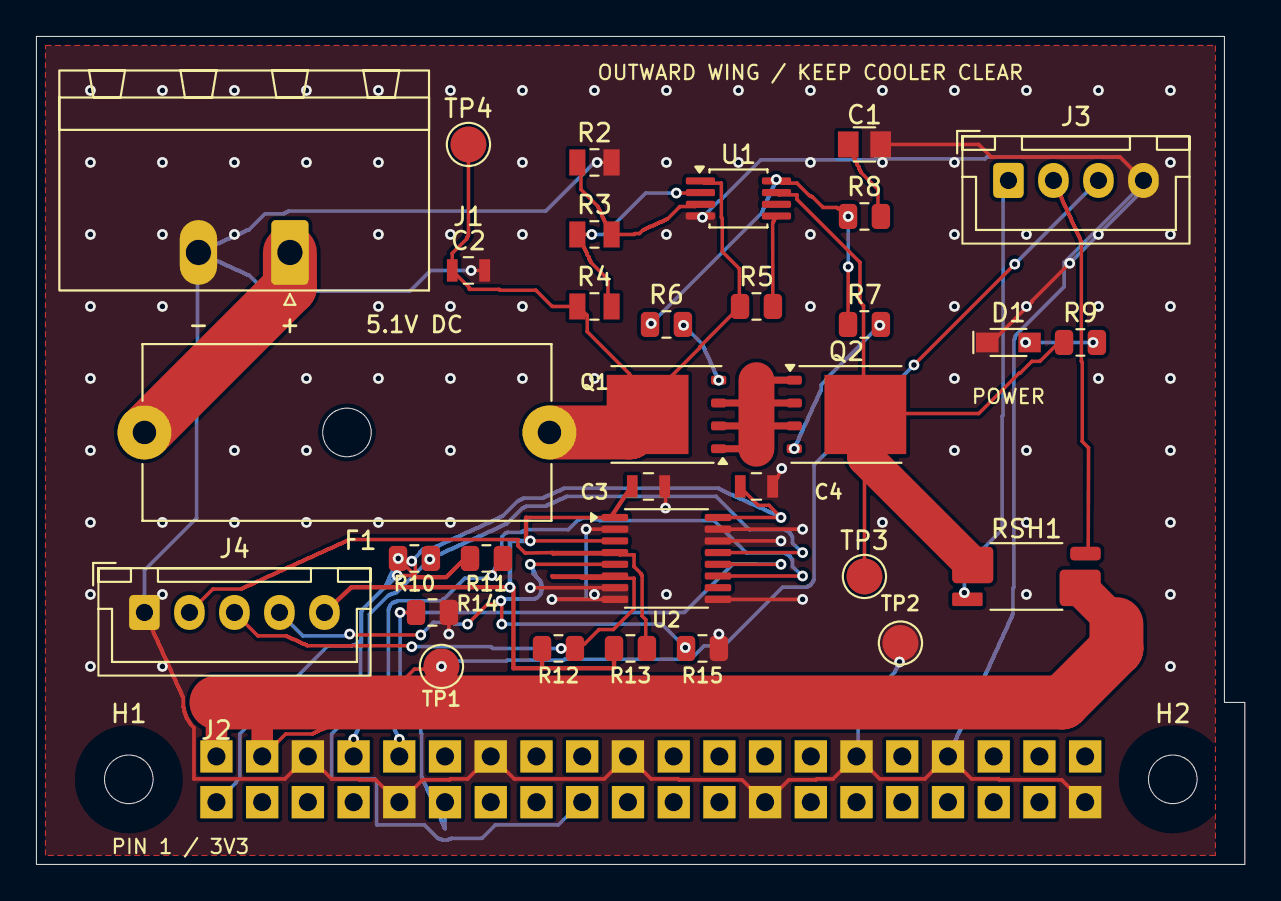
[picture p22: board interposer.kicad_pcb from above]

Board: 2 copper layers, 67.1 x 46.0 mm, 35 parts (0 on the bottom side), 24 nets.

Other parts of the board:
H1, H2: MountingHole_2.7mm_M2.5
