nherbaut/pico-power-sensor/hardware/pcb/carrier/carrier.kicad_pcb

## KiCad design hardware/pcb/carrier/carrier.kicad_pcb (2026-10-14)

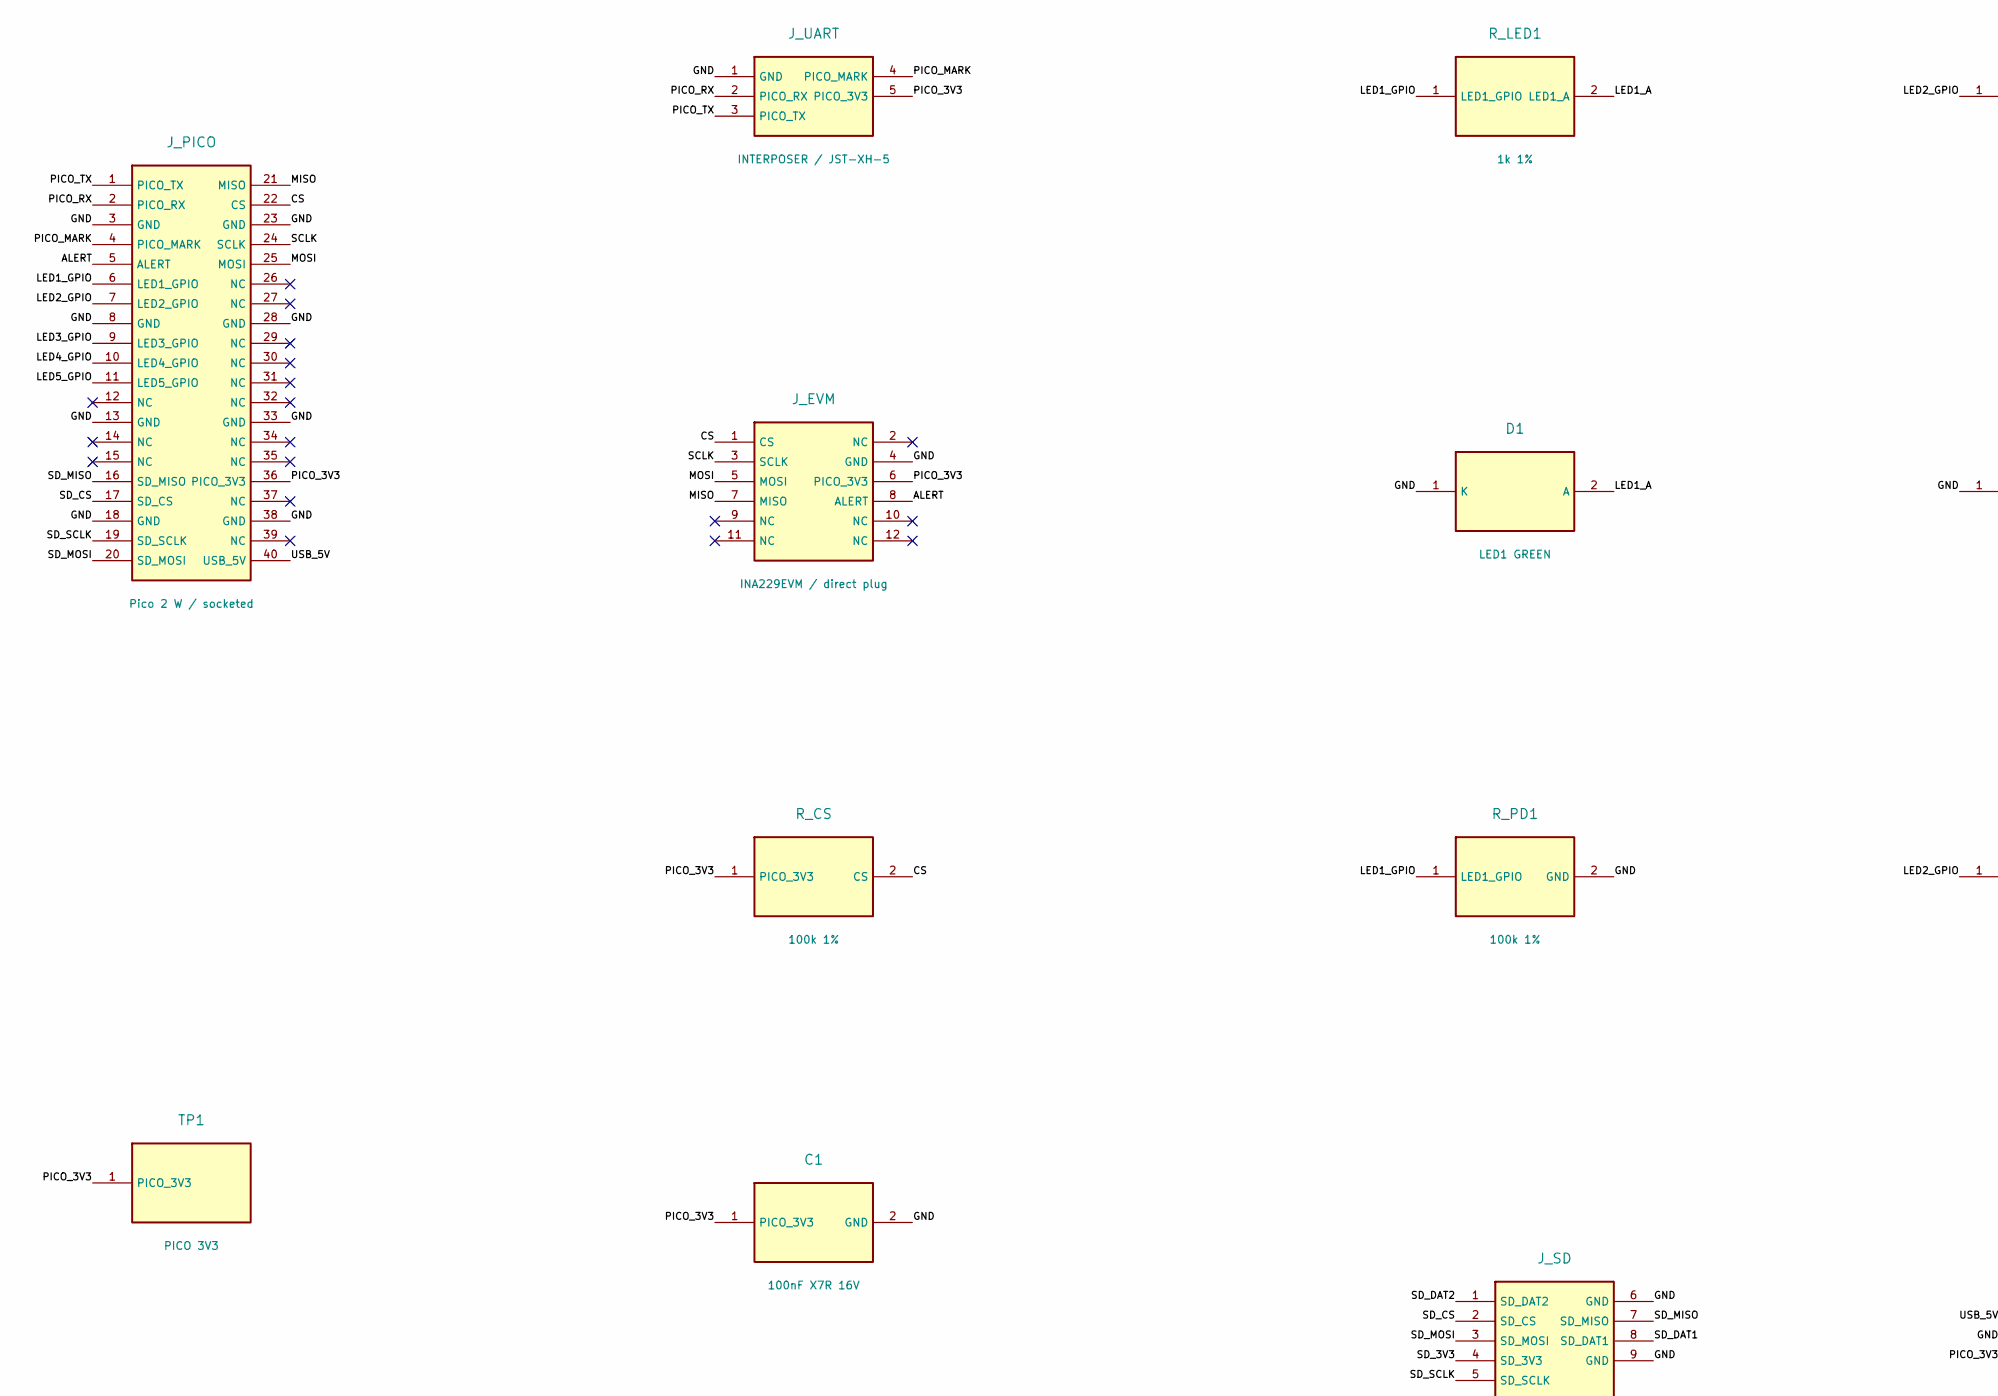
[picture p23: schematic carrier.kicad_sch, PicoPower instrument carrier, part in row 1, column 1]

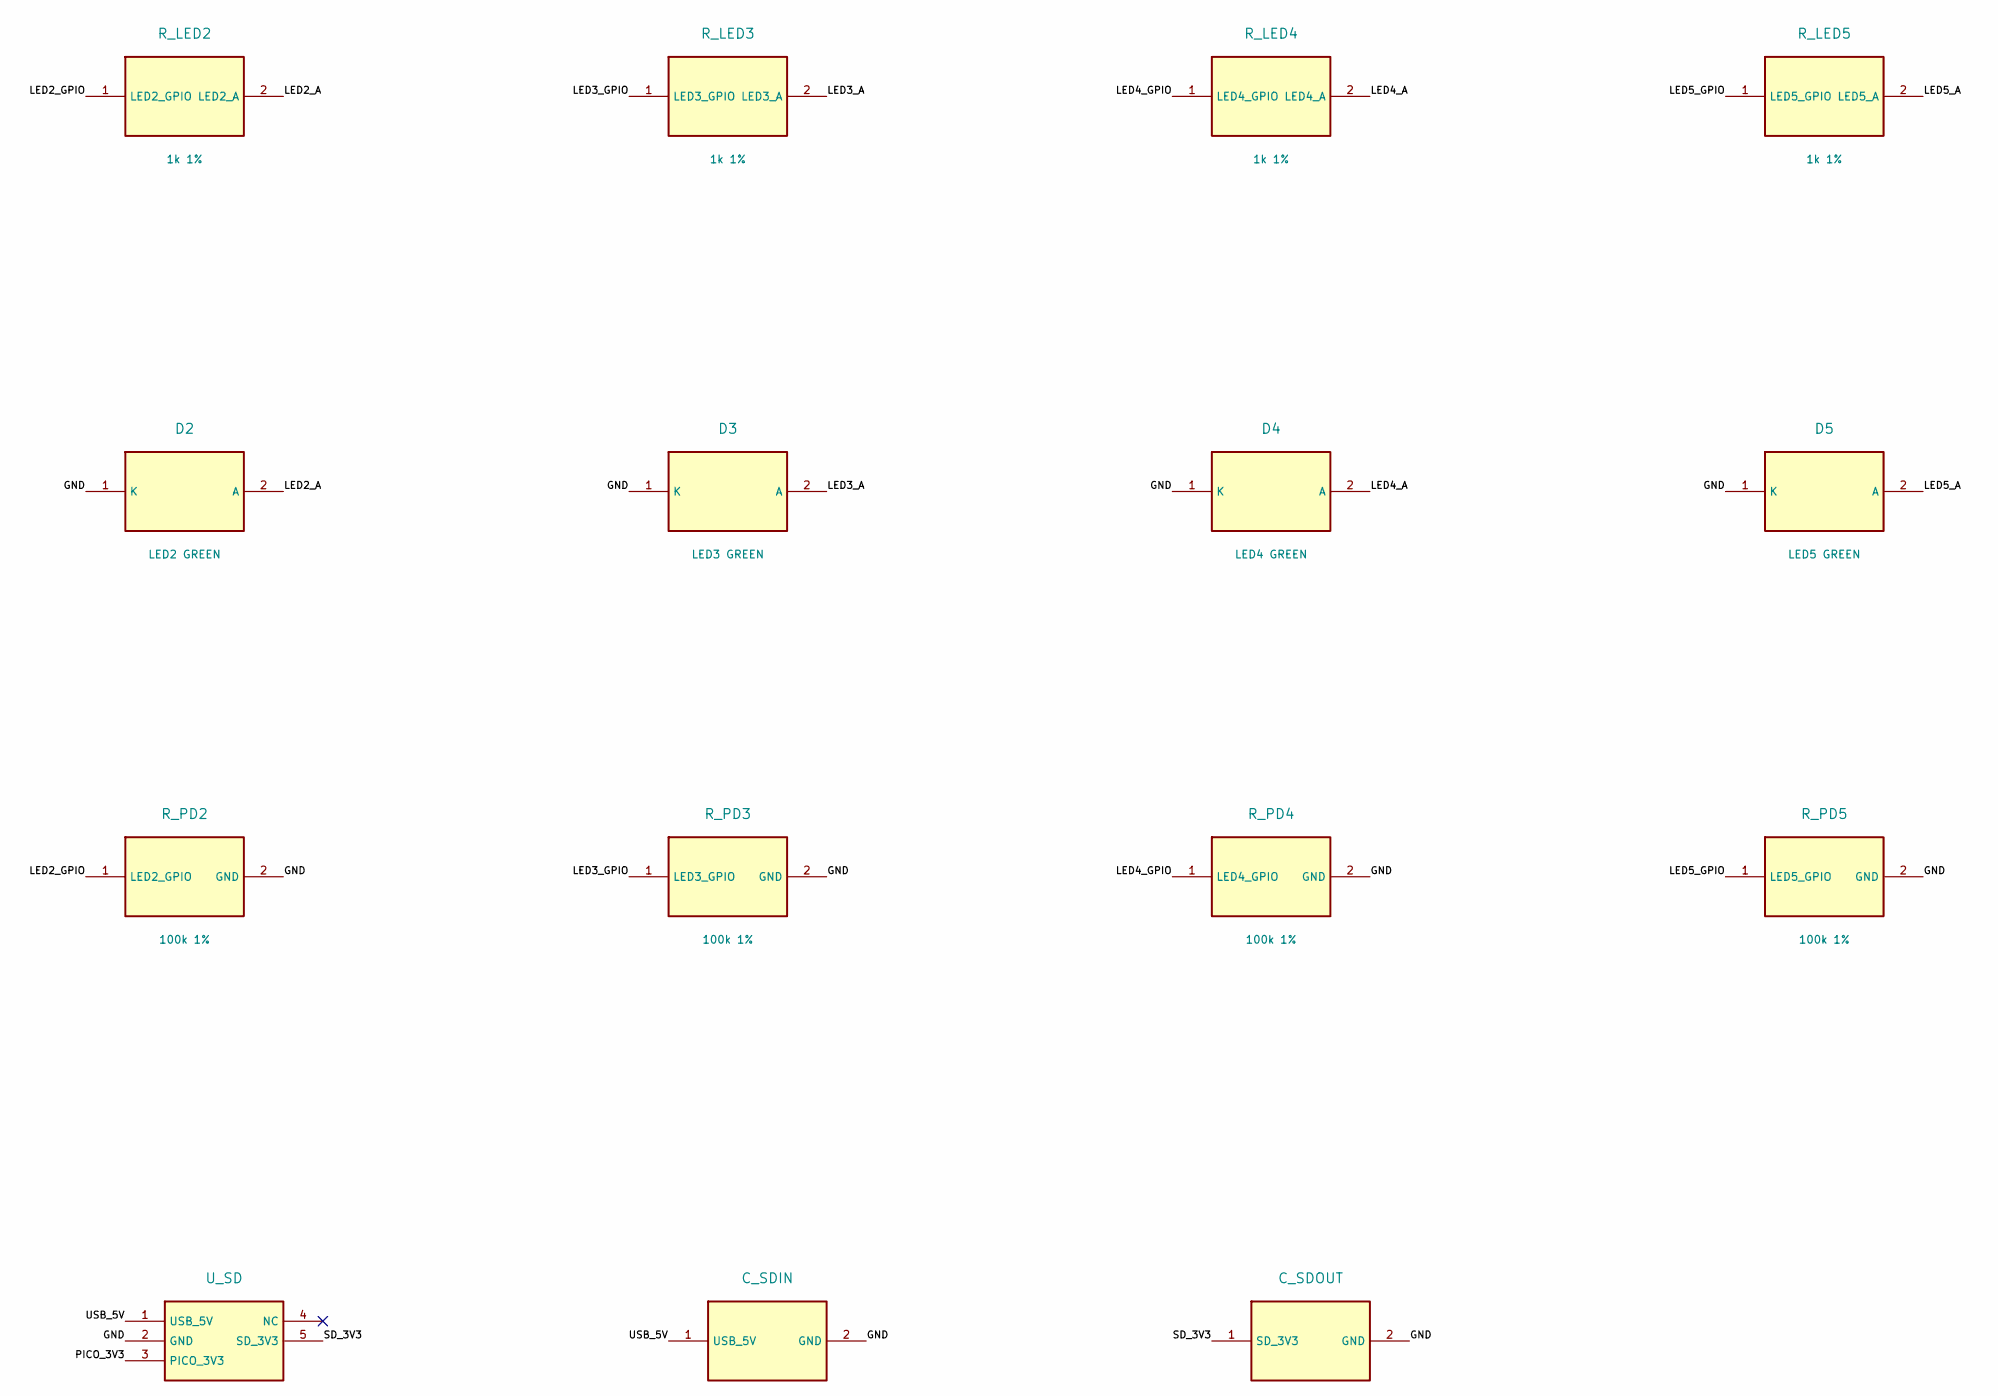
[picture p24: schematic carrier.kicad_sch, PicoPower instrument carrier, part in row 1, column 2]

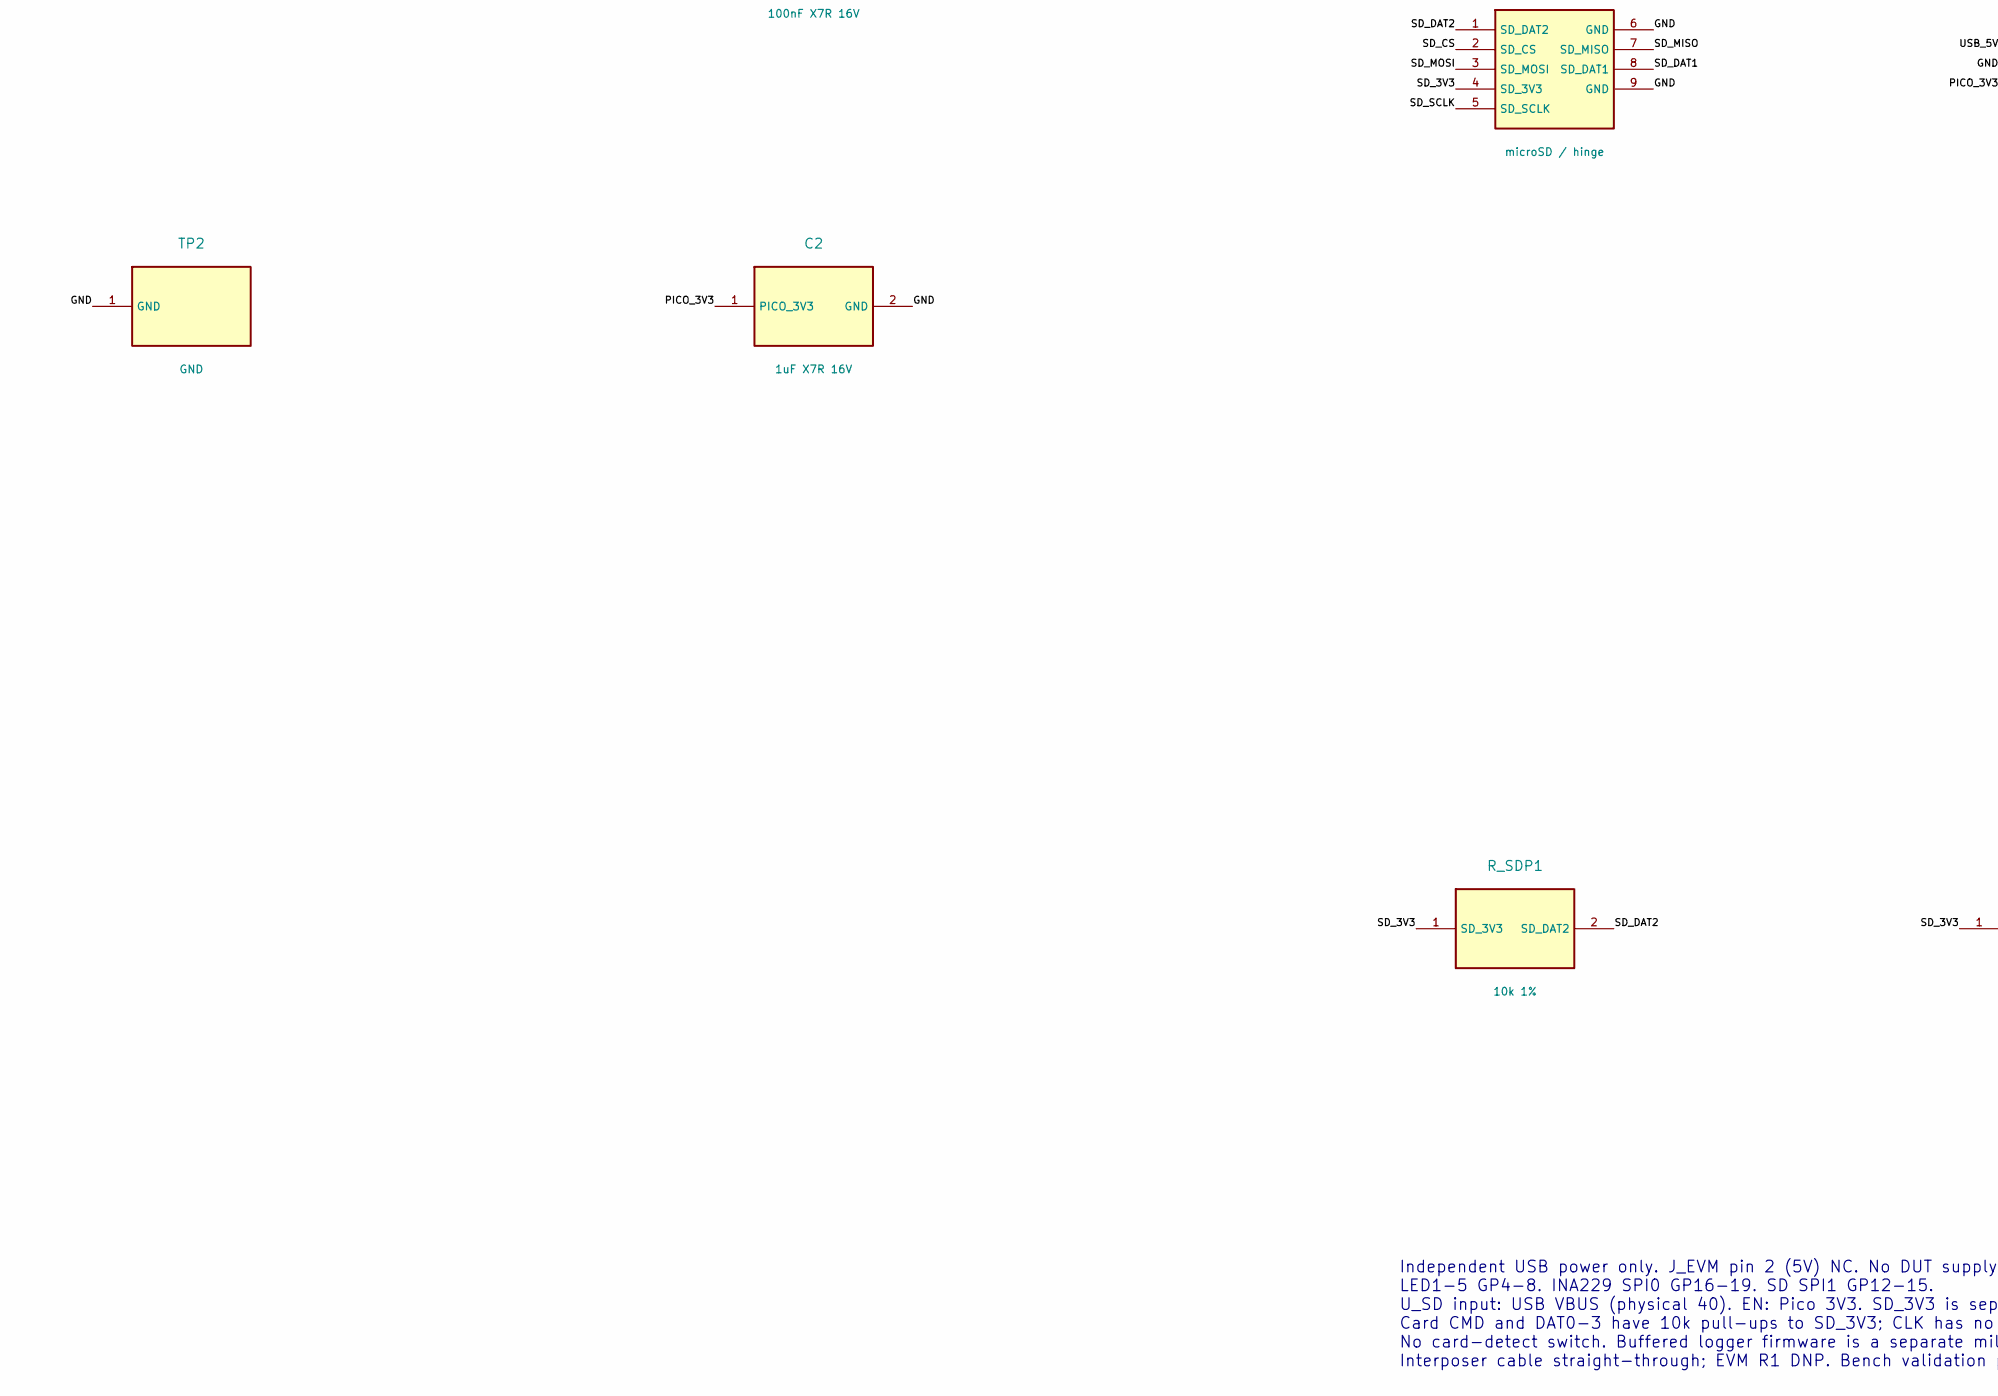
[picture p25: schematic carrier.kicad_sch, PicoPower instrument carrier, part in row 2, column 1]

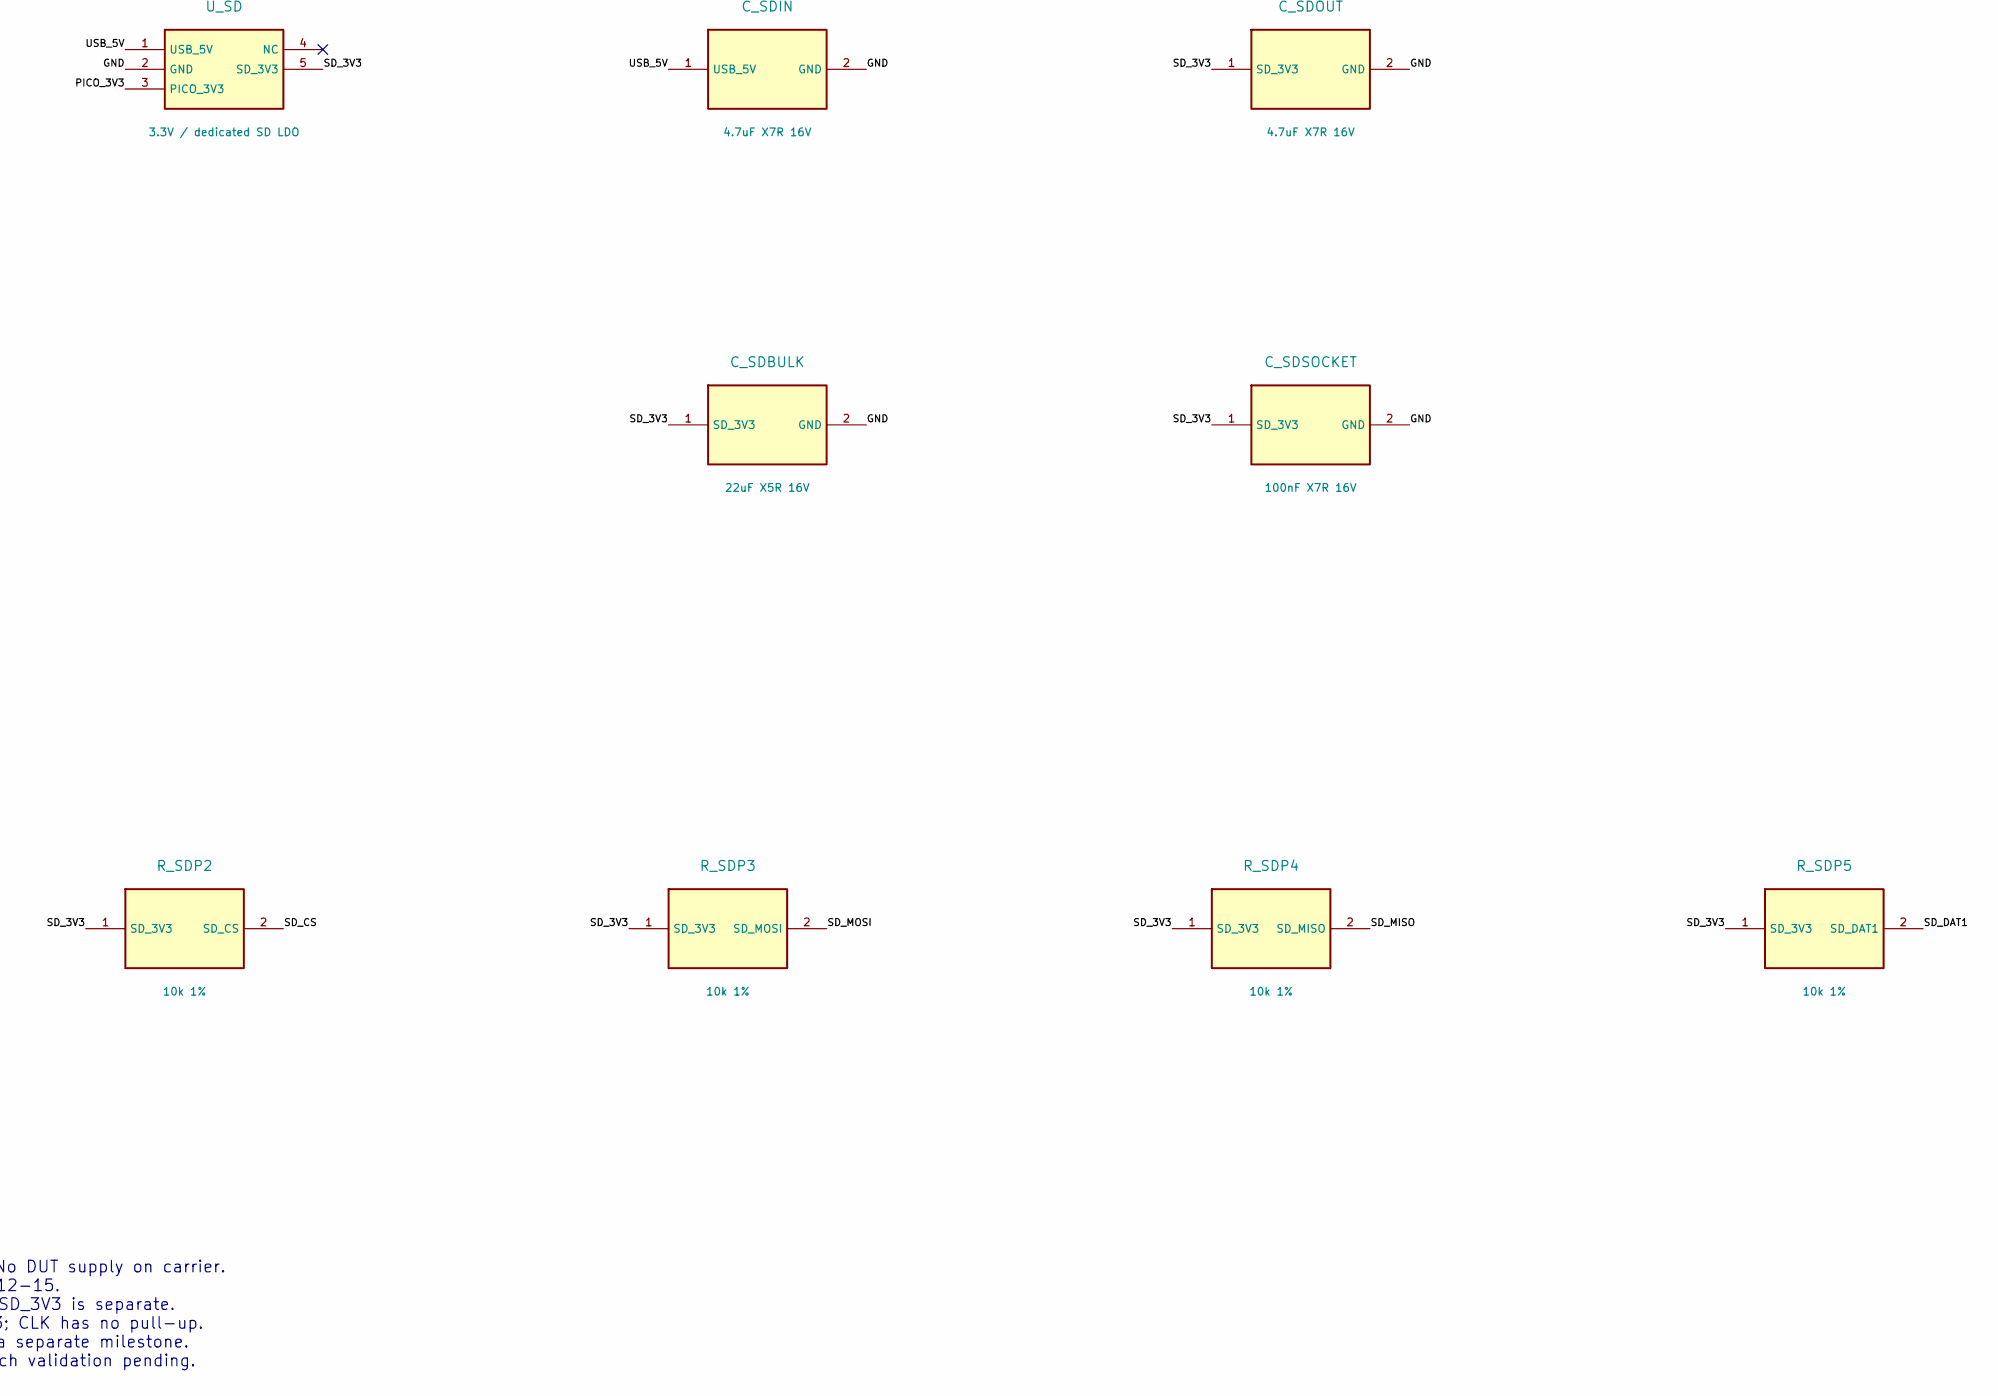
[picture p26: schematic carrier.kicad_sch, PicoPower instrument carrier, part in row 2, column 2]

Parts:
C1: 100nF X7R 16V; C_0805_Murata; MPN GRM21BR71C104KA01L
C2: 1uF X7R 16V; C_0805_Murata; MPN GRM21BR71C105KA01L
C_SDBULK: 22uF X5R 16V; C_1206; MPN CL31A226KOHNNNE
C_SDIN: 4.7uF X7R 16V; C_0805_Murata; MPN GRM21BR71C475KA73L
C_SDOUT: 4.7uF X7R 16V; C_0805_Murata; MPN GRM21BR71C475KA73L
C_SDSOCKET: 100nF X7R 16V; C_0805_Murata; MPN GRM21BR71C104KA01L
D1: LED1 GREEN; LED_0805; MPN APT2012LZGCK
D2: LED2 GREEN; LED_0805; MPN APT2012LZGCK
D3: LED3 GREEN; LED_0805; MPN APT2012LZGCK
D4: LED4 GREEN; LED_0805; MPN APT2012LZGCK
D5: LED5 GREEN; LED_0805; MPN APT2012LZGCK
J_EVM: INA229EVM / direct plug; NPPN062FJFN; MPN NPPN062FJFN-RC
J_PICO: Pico 2 W / socketed; Pico_Socketed; MPN Pico 2 W
J_SD: microSD / hinge; microSD_Wuerth; MPN 693072010801
J_UART: INTERPOSER / JST-XH-5; XH5; MPN B5B-XH-A(LF)(SN)
R_CS: 100k 1%; R_0805; MPN CRCW0805100KFKEA
R_LED1, R_LED2, R_LED3, R_LED4, R_LED5: 1k 1%; R_0805; MPN CRCW08051K00FKEA
R_PD1, R_PD2, R_PD3, R_PD4, R_PD5: 100k 1%; R_0805; MPN CRCW0805100KFKEA
R_SDP1, R_SDP2, R_SDP3, R_SDP4, R_SDP5: 10k 1%; R_0805; MPN CRCW080510K0FKEA
TP1: PICO 3V3; TestPoint
TP2: GND; TestPoint
U_SD: 3.3V / dedicated SD LDO; SOT23_5; MPN TLV75533PDBVR

Connections:
/ALERT: J_EVM.8 (ALERT), J_PICO.5 (ALERT)
/CS: J_EVM.1 (CS), J_PICO.22 (CS), R_CS.2 (CS)
/GND: C1.2 (GND), C2.2 (GND), C_SDBULK.2 (GND), C_SDIN.2 (GND), C_SDOUT.2 (GND), C_SDSOCKET.2 (GND), D1.1 (K), D2.1 (K), D3.1 (K), D4.1 (K), D5.1 (K), J_EVM.4 (GND), J_PICO.3 (GND), J_PICO.8 (GND), J_PICO.13 (GND), J_PICO.18 (GND), J_PICO.23 (GND), J_PICO.28 (GND), J_PICO.33 (GND), J_PICO.38 (GND), J_SD.6 (GND), J_SD.9 (GND), J_UART.1 (GND), R_PD1.2 (GND), R_PD2.2 (GND), R_PD3.2 (GND), R_PD4.2 (GND), R_PD5.2 (GND), TP2.1, U_SD.2 (GND)
/LED1_A: D1.2 (A), R_LED1.2 (LED1_A)
/LED1_GPIO: J_PICO.6 (LED1_GPIO), R_LED1.1 (LED1_GPIO), R_PD1.1 (LED1_GPIO)
/LED2_A: D2.2 (A), R_LED2.2 (LED2_A)
/LED2_GPIO: J_PICO.7 (LED2_GPIO), R_LED2.1 (LED2_GPIO), R_PD2.1 (LED2_GPIO)
/LED3_A: D3.2 (A), R_LED3.2 (LED3_A)
/LED3_GPIO: J_PICO.9 (LED3_GPIO), R_LED3.1 (LED3_GPIO), R_PD3.1 (LED3_GPIO)
/LED4_A: D4.2 (A), R_LED4.2 (LED4_A)
/LED4_GPIO: J_PICO.10 (LED4_GPIO), R_LED4.1 (LED4_GPIO), R_PD4.1 (LED4_GPIO)
/LED5_A: D5.2 (A), R_LED5.2 (LED5_A)
/LED5_GPIO: J_PICO.11 (LED5_GPIO), R_LED5.1 (LED5_GPIO), R_PD5.1 (LED5_GPIO)
/MISO: J_EVM.7 (MISO), J_PICO.21 (MISO)
/MOSI: J_EVM.5 (MOSI), J_PICO.25 (MOSI)
/PICO_3V3: C1.1 (PICO_3V3), C2.1 (PICO_3V3), J_EVM.6 (PICO_3V3), J_PICO.36 (PICO_3V3), J_UART.5 (PICO_3V3), R_CS.1 (PICO_3V3), TP1.1, U_SD.3 (PICO_3V3)
/PICO_MARK: J_PICO.4 (PICO_MARK), J_UART.4 (PICO_MARK)
/PICO_RX: J_PICO.2 (PICO_RX), J_UART.2 (PICO_RX)
/PICO_TX: J_PICO.1 (PICO_TX), J_UART.3 (PICO_TX)
/SCLK: J_EVM.3 (SCLK), J_PICO.24 (SCLK)
/SD_3V3: C_SDBULK.1 (SD_3V3), C_SDOUT.1 (SD_3V3), C_SDSOCKET.1 (SD_3V3), J_SD.4 (SD_3V3), R_SDP1.1 (SD_3V3), R_SDP2.1 (SD_3V3), R_SDP3.1 (SD_3V3), R_SDP4.1 (SD_3V3), R_SDP5.1 (SD_3V3), U_SD.5 (SD_3V3)
/SD_CS: J_PICO.17 (SD_CS), J_SD.2 (SD_CS), R_SDP2.2 (SD_CS)
/SD_DAT1: J_SD.8 (SD_DAT1), R_SDP5.2 (SD_DAT1)
/SD_DAT2: J_SD.1 (SD_DAT2), R_SDP1.2 (SD_DAT2)
/SD_MISO: J_PICO.16 (SD_MISO), J_SD.7 (SD_MISO), R_SDP4.2 (SD_MISO)
/SD_MOSI: J_PICO.20 (SD_MOSI), J_SD.3 (SD_MOSI), R_SDP3.2 (SD_MOSI)
/SD_SCLK: J_PICO.19 (SD_SCLK), J_SD.5 (SD_SCLK)
/USB_5V: C_SDIN.1 (USB_5V), J_PICO.40 (USB_5V), U_SD.1 (USB_5V)

Notes on the sheet:
Independent USB power only. J_EVM pin 2 (5V) NC. No DUT supply on carrier. LED1-5 GP4-8. INA229 SPI0 GP16-19. SD SPI1 GP12-15. U_SD input: USB VBUS (physical 40). EN: Pico 3V3. SD_3V3 is separate. Card CMD and DAT0-3 have 10k pull-ups to SD_3V3; CLK has no pull-up. No card-detect switch. Buffered l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

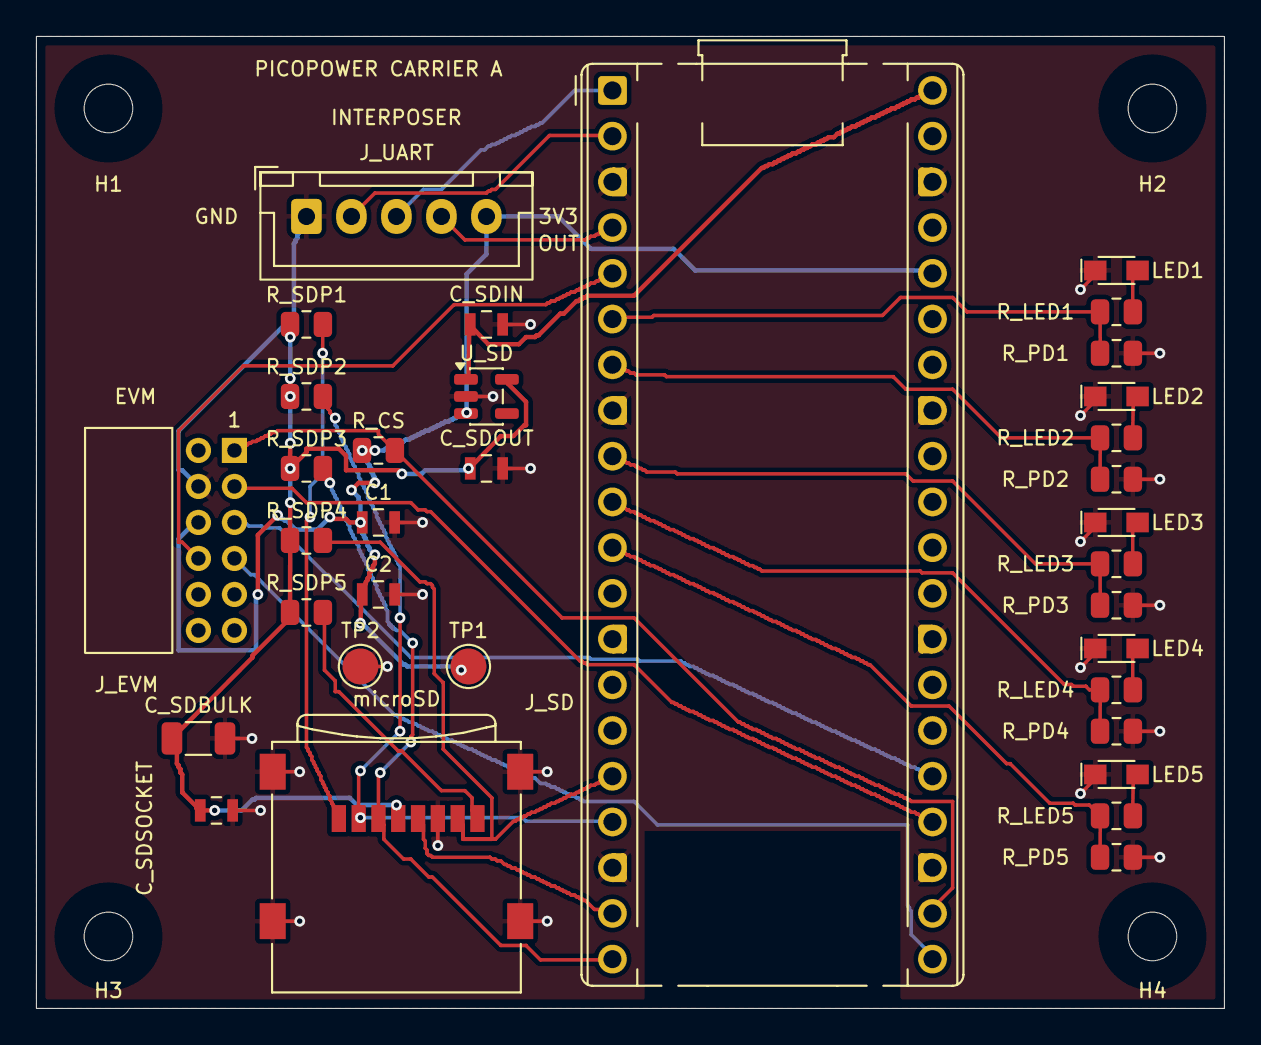
[picture p27: board carrier.kicad_pcb from above]

Board: 2 copper layers, 66.0 x 54.0 mm, 38 parts (0 on the bottom side), 28 nets.

Other parts of the board:
H1, H2, H3, H4: MountingHole_2.7mm_M2.5
